eric-wieser/2.12-robot/software/Kinect/colour_125cm.jpg

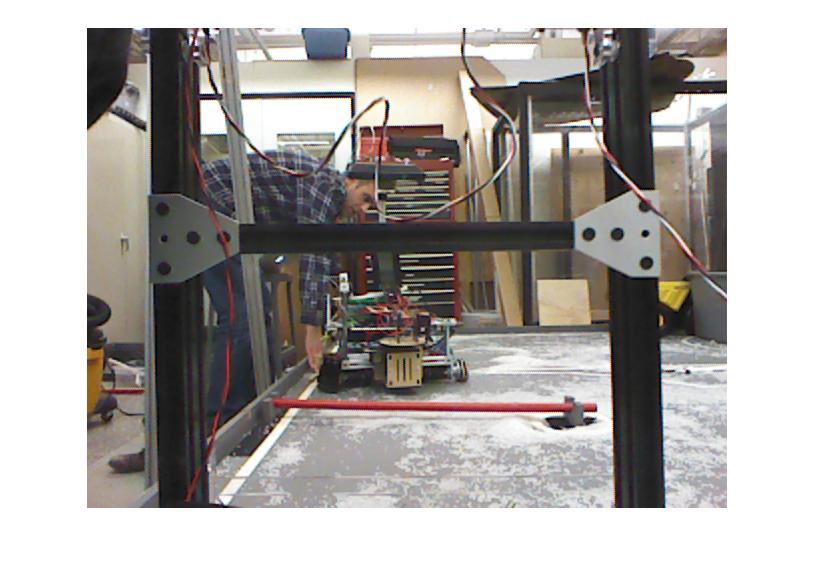
software/Kinect/colour_125cm.jpg
