eric-wieser/2.12-robot/README.md

2.12 CAD files for MECEM
========================
