eric-wieser/2.12-robot/software/README.md

Top level classes:

* Navigator
* Rail
* Arm
* ArenaPlotter

Note that due to problems with matlabs garbage collector, you pretty much have to restart matlab if the arduino connection goes to pieces
