eric-wieser/2.12-robot/software/embedded/README.md

You'll need a new version of the [motor driver library](https://github.com/eric-wieser/dual-mc33926-motor-shield) to run this code.

Most of the files here have been created by pulling apart the lab3 solution code.
