eric-wieser/2.12-robot/software/Arena.PNG

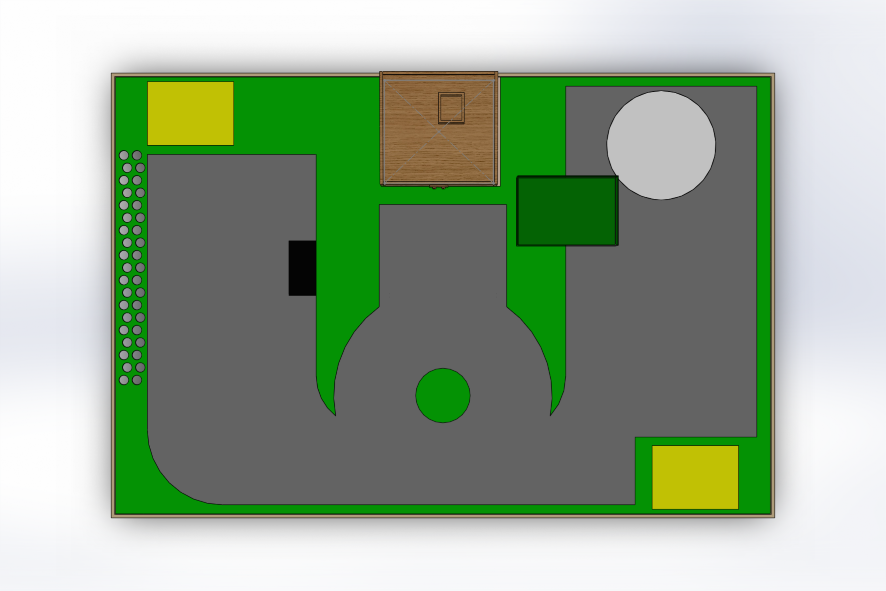
software/Arena.PNG
