eric-wieser/2.12-robot/software/Kinect/data.jpg

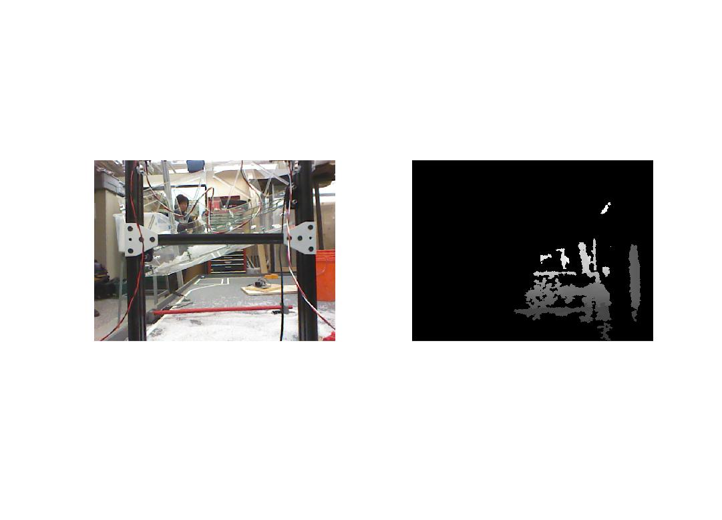
software/Kinect/data.jpg
