eric-wieser/2.12-robot/software/Kinect/depth_125cm.jpg

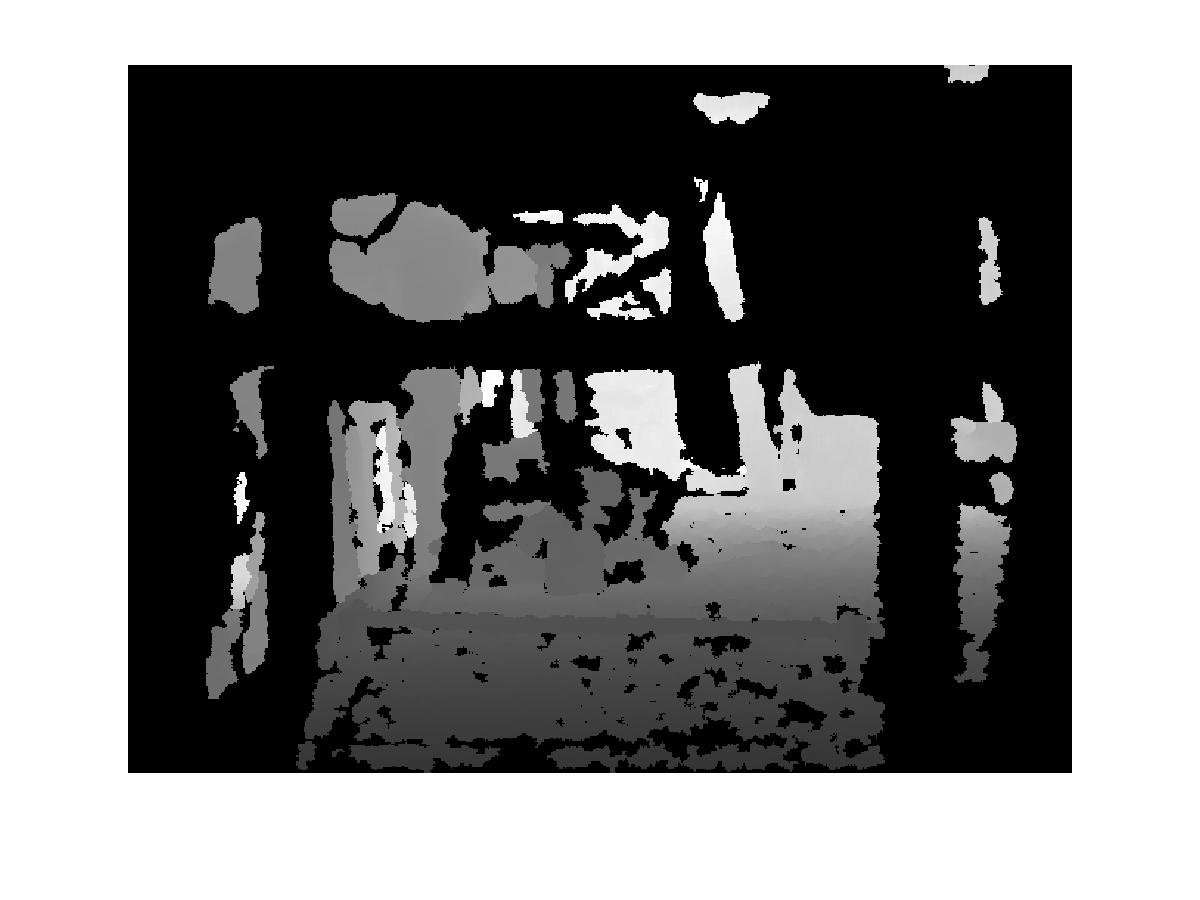
software/Kinect/depth_125cm.jpg
