eric-wieser/2.12-robot/hardware/Parts/Hand/Hand_new/Sheet4_scrapper.SLDASM

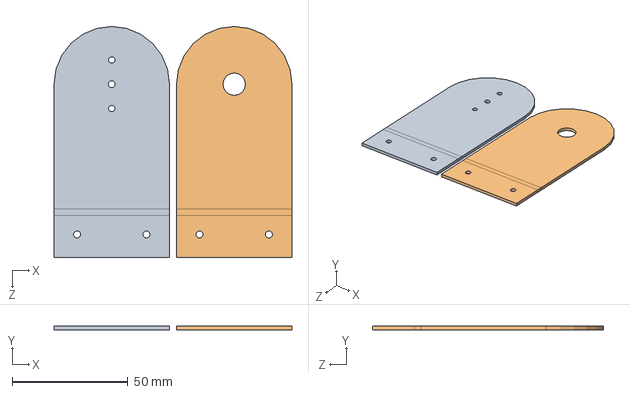
[picture p5: CAD file, 2015-12-03]
hardware/Parts/Hand/Hand_new/Sheet4_scrapper.SLDASM
103.0 x 1.59 x 100.0 mm
HandLink3_new
HandLink3_2_new
