eric-wieser/2.12-robot/hardware/Parts/Rail/Servo pulley with shaft.SLDASM

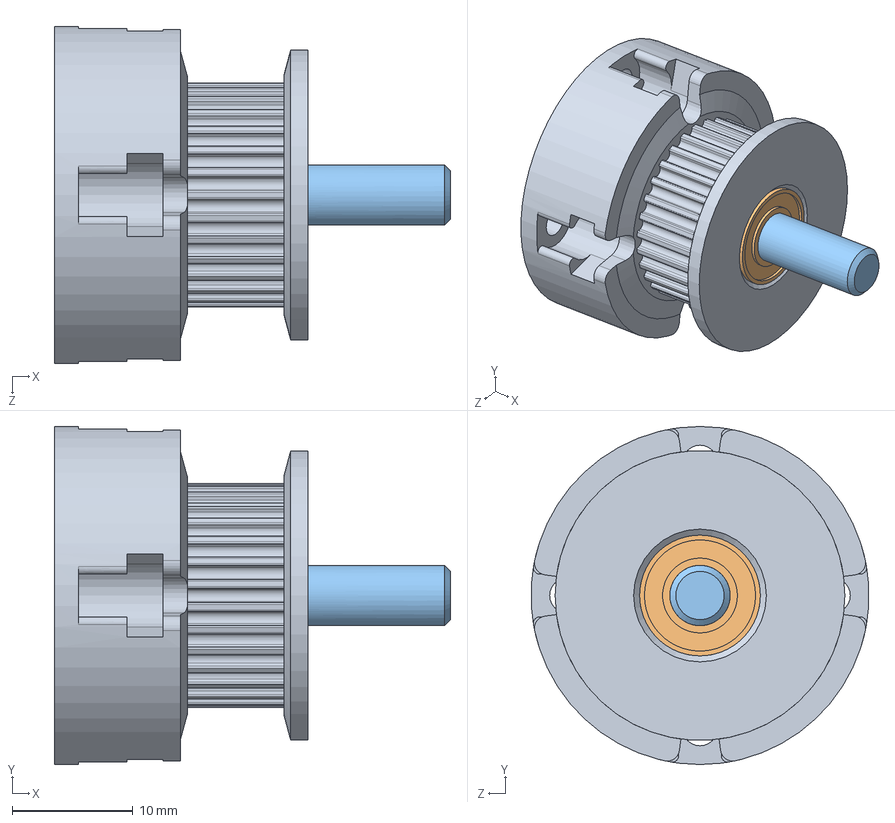
[picture p6: CAD file, 2015-12-03]
hardware/Parts/Rail/Servo pulley with shaft.SLDASM
32.8 x 28.0 x 27.9 mm
Servo Timing Pulley 30 Tooth
Ball Bearing 5 x 10 x 4.2 x 2
Low Profile Screw M5
