eric-wieser/2.12-robot/hardware/Parts/Sifter/Sifter.SLDASM

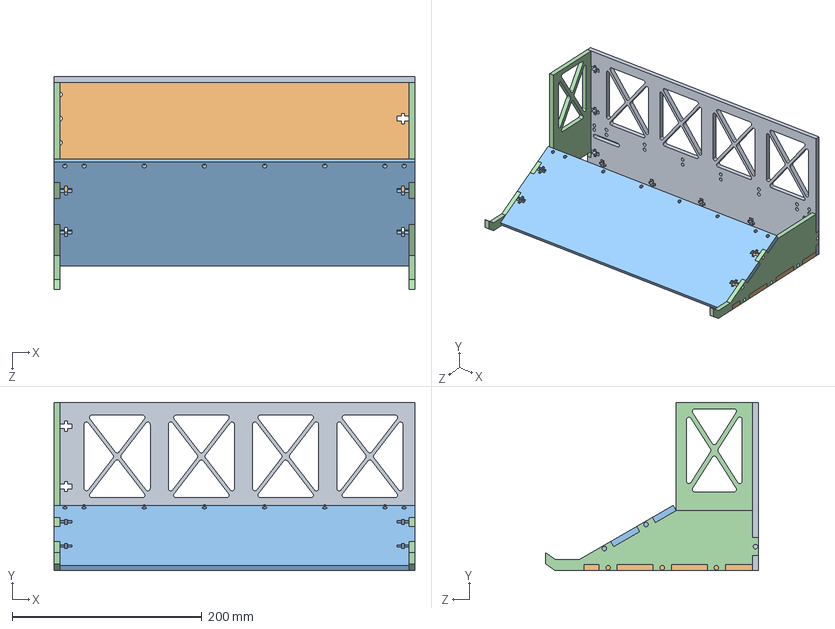
[picture p7: CAD file, 2015-12-01]
hardware/Parts/Sifter/Sifter.SLDASM
381.0 x 177.8 x 224.8 mm
Back_plate
Bottom_plate
front_plate
Bottom_side_panel x 2
