eric-wieser/2.12-robot/hardware/Top.SLDASM

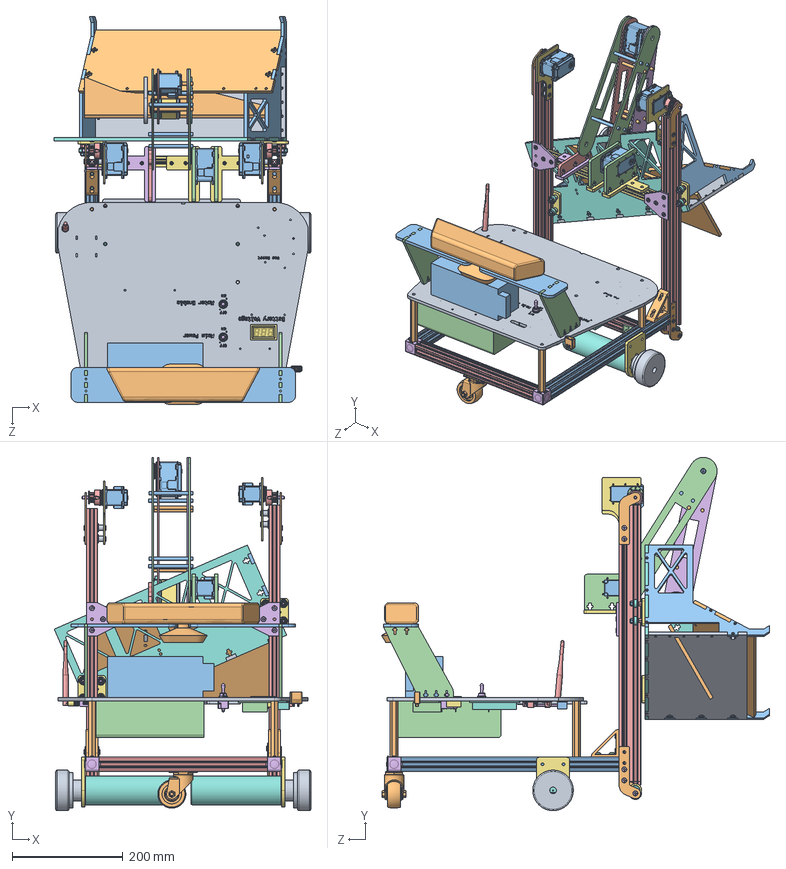
[picture p8: CAD file, 2015-12-03]
hardware/Top.SLDASM
463.9 x 639.1 x 701.7 mm
RobotTopPlatform_ZACK_EDIT
BaseStandoff x 4
EncoderBufferBoard
PC
wireless
usb
wireless2
zapt
Screen
Kinect_Sensor
Battery
DROK DCDC
Arduino UNO
Switch x 2
VDC1
ScreenBoard
ScreenHolder
xt90_male_asm
Kinect shelf plate
kinect shelf side panel x 2
8020_extrusion x 2
8020_corner x 2
motor mounting plate x 2
IG520053-SY3465 x 2
wheel_basic x 2
caster
47065T209bis x 2
47065T236 x 2
V-Slot 20x40x500 Linear Rail x 2
Double Tee Nut x 10
Mini V Wheel Plate x 2
Delrin Mini V Wheel x 8
Ball Bearing 5 x 10 x 4.2 x 20
Precision Shim 8 x 5 x 1 x 16
Nylon Insert Lock Nut M5 x 10
Aluminum Spacer 6mm x 4
Mini Eccentric Spacer 6mm x 4
Low Profile Screw M5 x 38
Smooth Idler Pulley Wheel x 2
Ball Bearing 5 x 16 x 5 x 4
Nylon Spacer 0.125in x 2
IdlerPlate x 6
MX-106T x 4
HN05-N102 x 4
Servo Timing Pulley 30 Tooth x 2
Aluminum Spacer 3mm x 4
Motor Mount x 2
Slot Washer 15 x 5 x 2 x 4
Aluminum Spacer 9mm x 4
Triangle_Bracket x 2
47065T147 End feed fastener without screws
47065T147 End feed fastener screws x 2
Tee Nut x 6
Joining Plate T x 2
Link
Back_plate
Bottom_plate
front_plate
Bottom_side_panel x 2
HandLink1_new x 2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
