eric-wieser/2.12-robot/Top.SLDASM

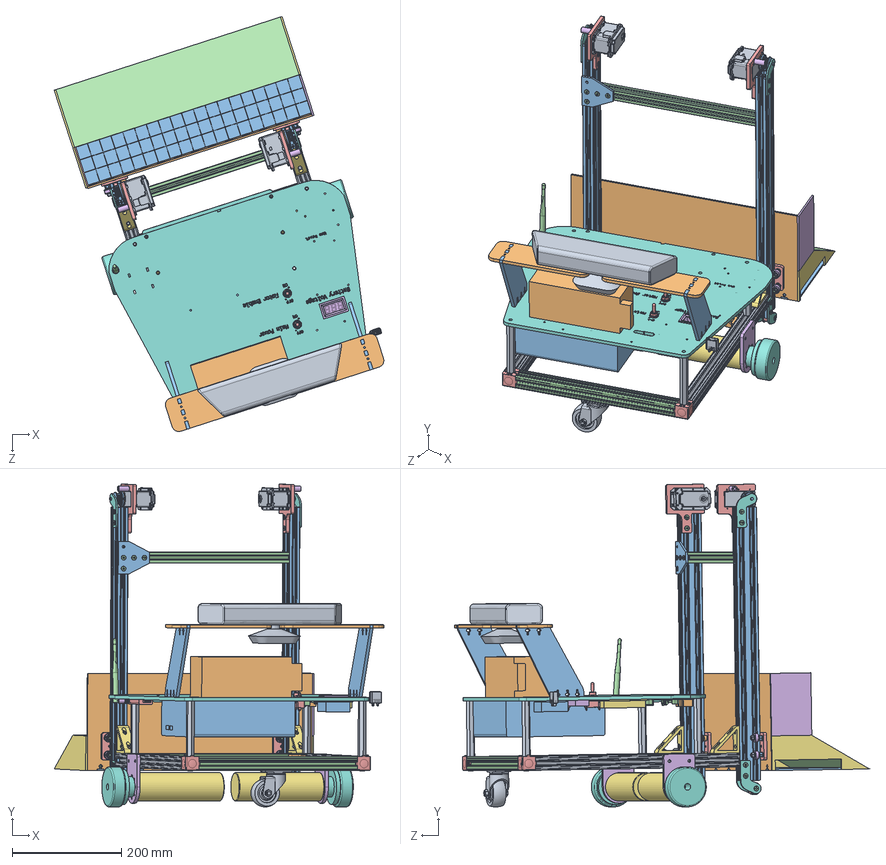
[picture p9: CAD file, 2015-11-05]
Top.SLDASM
603.1 x 590.5 x 759.1 mm
47065T209bis x 2
47065T236 x 2
V-Slot 20x40x500 Linear Rail x 2
Double Tee Nut x 10
Mini V Wheel Plate x 2
Delrin Mini V Wheel x 8
Ball Bearing 5 x 10 x 4.2 x 16
Precision Shim 8 x 5 x 1 x 16
Nylon Insert Lock Nut M5 x 10
Aluminum Spacer 6mm x 4
Mini Eccentric Spacer 6mm x 4
Low Profile Screw M5 x 32
Smooth Idler Pulley Wheel x 2
Ball Bearing 5 x 16 x 5 x 4
Nylon Spacer 0.125in x 2
IdlerPlate x 6
MX-106T x 2
HN05-N102 x 2
Servo Timing Pulley 30 Tooth x 2
Aluminum Spacer 3mm x 4
Motor Mount x 2
Aluminum Spacer 20mm x 2
Triangle_Bracket x 2
RobotTopPlatform_ZACK_EDIT
BaseStandoff x 4
EncoderBufferBoard
PC
wireless
usb
wireless2
zapt
Screen
Kinect_Sensor
Battery
DROK DCDC
Arduino UNO
Switch x 2
VDC1
ScreenBoard
ScreenHolder
xt90_male_asm
Kinect shelf plate
kinect shelf side panel x 2
8020_extrusion x 2
8020_corner x 2
motor mounting plate x 2
IG520053-SY3465 x 2
wheel_basic x 2
caster
Back_plate
Bottom_plate
front_plate
Chicken_wire
Top_side_panel
Bottom_side_panel x 2
47065T147 End feed fastener without screws
47065T147 End feed fastener screws x 2
Tee Nut x 2
Joining Plate T
V-Slot 20x20x500 Linear Rail - Link
