eric-wieser/2.12-robot/hardware/BaseRobot/TopAssembly.SLDASM

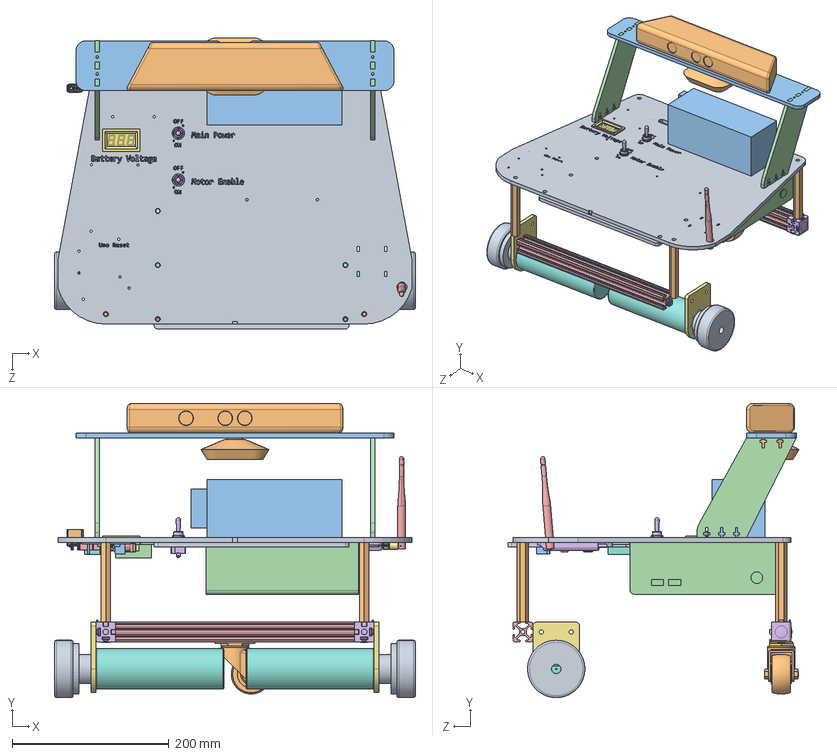
[picture p10: CAD file, 2015-12-03]
hardware/BaseRobot/TopAssembly.SLDASM
461.2 x 376.0 x 372.0 mm
RobotTopPlatform_ZACK_EDIT
BaseStandoff x 4
EncoderBufferBoard
PC
wireless
usb
wireless2
zapt
Screen
Kinect_Sensor
Battery
DROK DCDC
Arduino UNO
Switch x 2
VDC1
ScreenBoard
ScreenHolder
xt90_male_asm
Kinect shelf plate
kinect shelf side panel x 2
8020_extrusion x 2
8020_corner x 2
motor mounting plate x 2
IG520053-SY3465 x 2
wheel_basic x 2
caster
