eric-wieser/2.12-robot/hardware/Sheet2.SLDASM

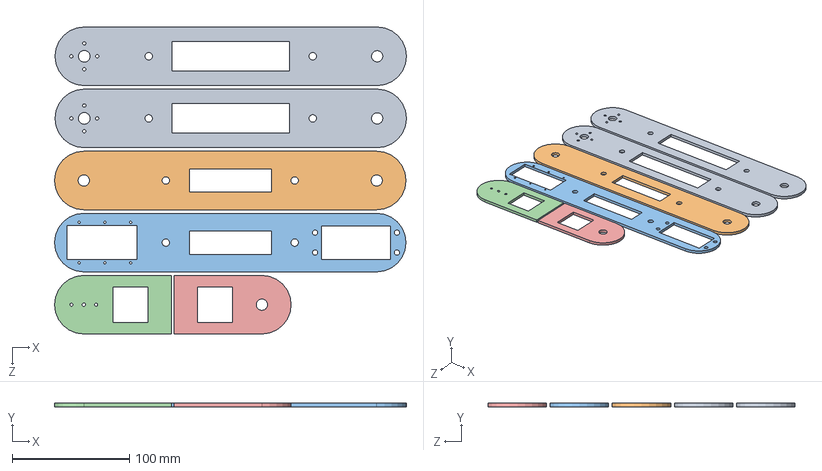
[picture p11: CAD file, 2015-12-01]
hardware/Sheet2.SLDASM
300.4 x 3.17 x 262.0 mm
HandLink1_new x 2
HandLink2_2_new
HandLink2_new_vs_11
HandLink3_new
HandLink3_2_new
