eric-wieser/2.12-robot/hardware/BaseRobot/TPLink.SLDASM

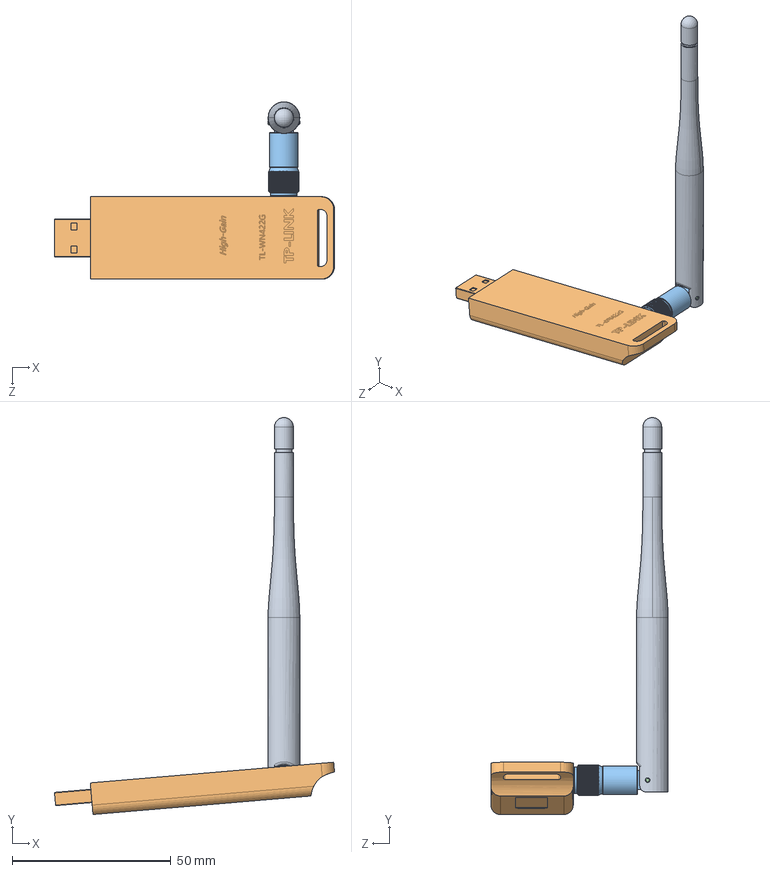
[picture p12: CAD file, 2015-12-01]
hardware/BaseRobot/TPLink.SLDASM
88.3 x 125.1 x 55.9 mm
wireless
usb
wireless2
zapt
