eric-wieser/2.12-robot/hardware/Parts/Hand/Hand_assembly.SLDASM

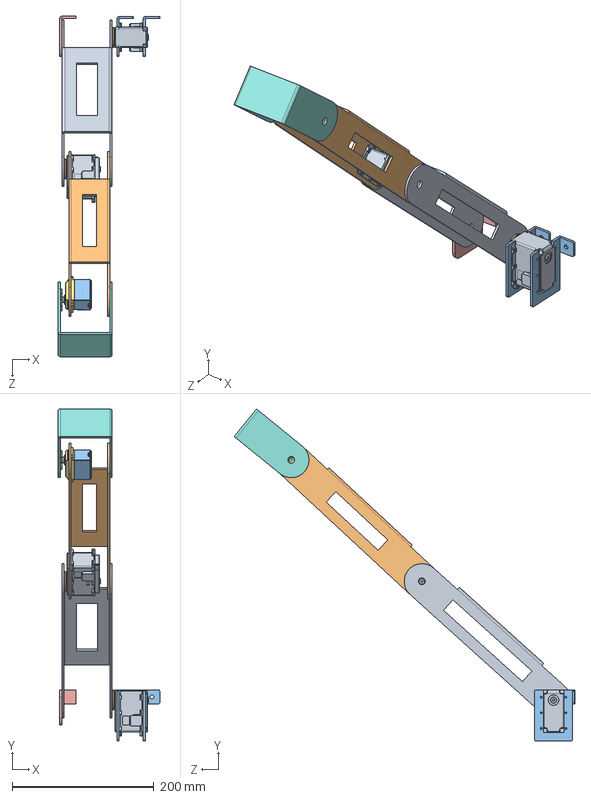
[picture p13: CAD file, 2015-11-13]
hardware/Parts/Hand/Hand_assembly.SLDASM
143.3 x 468.2 x 480.3 mm
HandLink1
HandLink2
MID_PLANT
chassis lower(None)
Output gear(M0.4x42T_FT)
SCREW M2.0XL28(None) x 4
chassis upper(None)
HandLink3
MX-106T x 2
HN05-N102 x 2
ServoMountArm x 2
ServoHornLink2
HandLink1Mount
