eric-wieser/2.12-robot/hardware/Parts/Hand/Hand_new/Hand_assembly_new.SLDASM

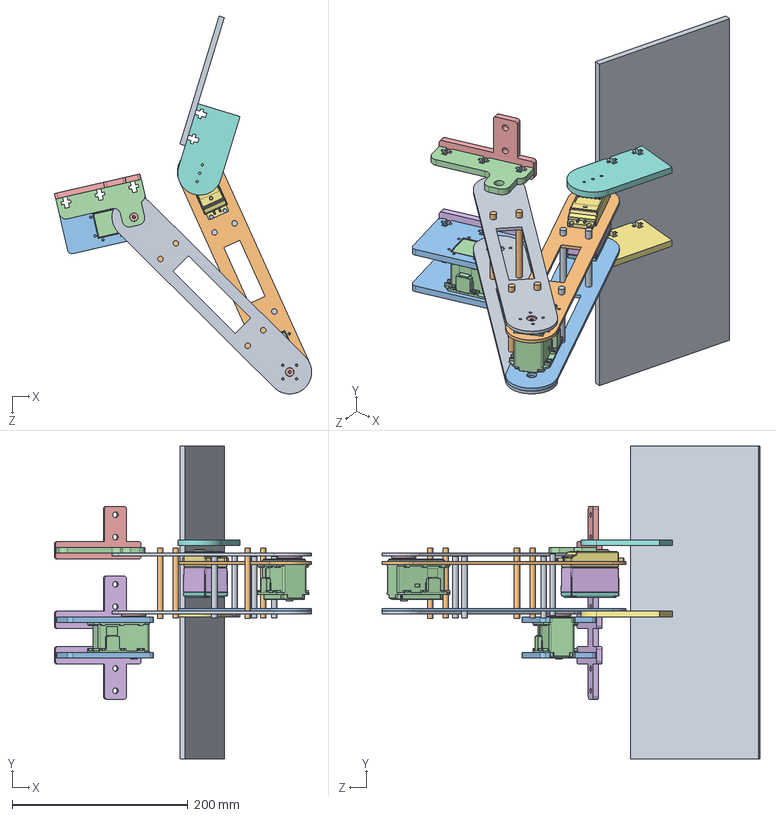
[picture p14: CAD file, 2015-12-03]
hardware/Parts/Hand/Hand_new/Hand_assembly_new.SLDASM
292.8 x 355.6 x 430.0 mm
HandLink1_new x 2
HandLink2_new_vs_11
HandLink2_2_new
MX-106T x 2
HN05-N102 x 2
MID-PLANT
CHASSIS-UPPER
CHASSIS-LOWER
LinkingBar x 4
LinkingBar2 x 4
Motor_mount_angled x 2
arm_mount
mounting_plate
motor_mount_large
Servo-arm-link
Servo-Scraper_link
Scraper_acrylic
