eric-wieser/2.12-robot/hardware/Parts/Rail/Rail.SLDASM

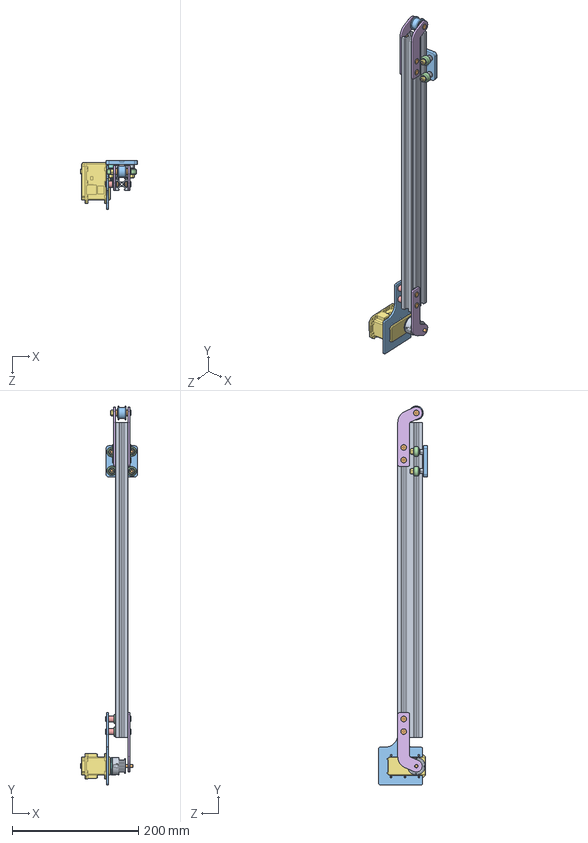
[picture p15: CAD file, 2015-12-03]
hardware/Parts/Rail/Rail.SLDASM
90.5 x 601.4 x 77.7 mm
V-Slot 20x40x500 Linear Rail
Double Tee Nut x 4
Mini V Wheel Plate
Delrin Mini V Wheel x 4
Ball Bearing 5 x 10 x 4.2 x 10
Precision Shim 8 x 5 x 1 x 8
Nylon Insert Lock Nut M5 x 5
Aluminum Spacer 6mm x 2
Mini Eccentric Spacer 6mm x 2
Low Profile Screw M5 x 14
Smooth Idler Pulley Wheel
Ball Bearing 5 x 16 x 5 x 2
Nylon Spacer 0.125in
IdlerPlate x 3
MX-106T
HN05-N102
Servo Timing Pulley 30 Tooth
Aluminum Spacer 3mm x 2
Motor Mount
Slot Washer 15 x 5 x 2 x 2
Aluminum Spacer 9mm x 2
