eric-wieser/2.12-robot/hardware/Sheet1.SLDASM

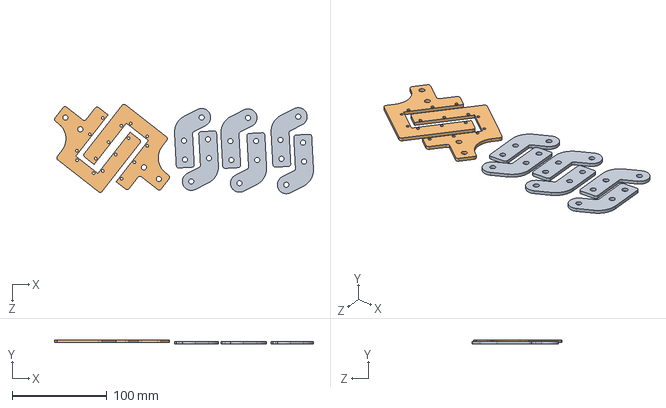
[picture p16: CAD file, 2015-11-13]
hardware/Sheet1.SLDASM
273.0 x 4.50 x 94.4 mm
IdlerPlate x 6
Motor Mount x 2
