eric-wieser/2.12-robot/hardware/Arena/Board Assembly.SLDASM

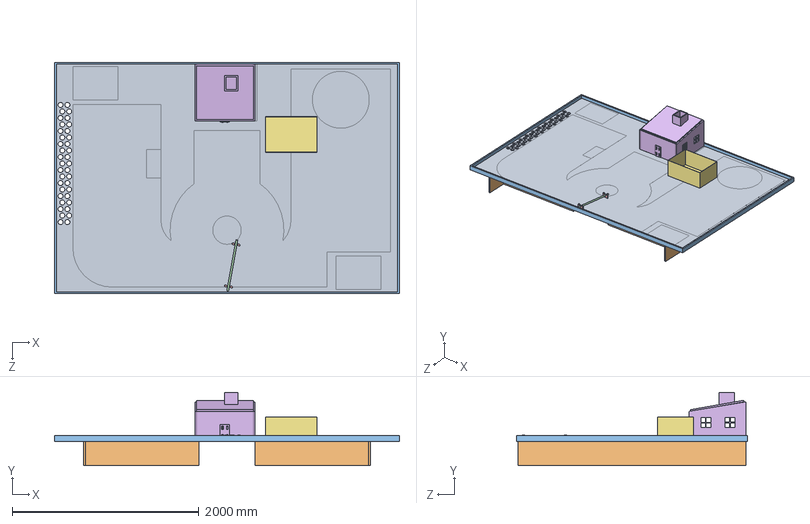
[picture p17: CAD file, 2015-10-30]
hardware/Arena/Board Assembly.SLDASM
3695.7 x 784.5 x 2476.5 mm
Board
Base
Wall
Tree
Tree Support
house
dumpster
