eric-wieser/2.12-robot/hardware/Arena/Tree Assembly.SLDASM

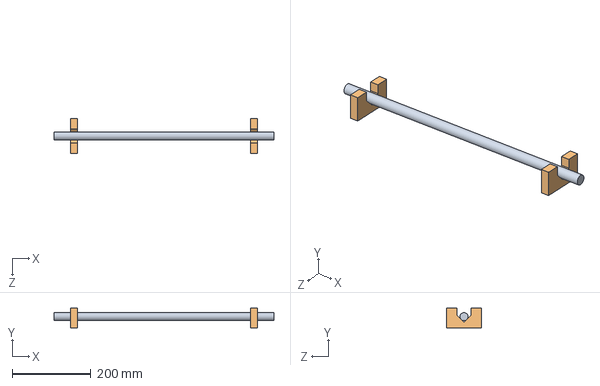
[picture p18: CAD file, 2015-10-30]
hardware/Arena/Tree Assembly.SLDASM
558.8 x 50.8 x 88.9 mm
Tree
Tree Support
