eric-wieser/2.12-robot/hardware/BaseRobot/Switch/S1A.SLDASM

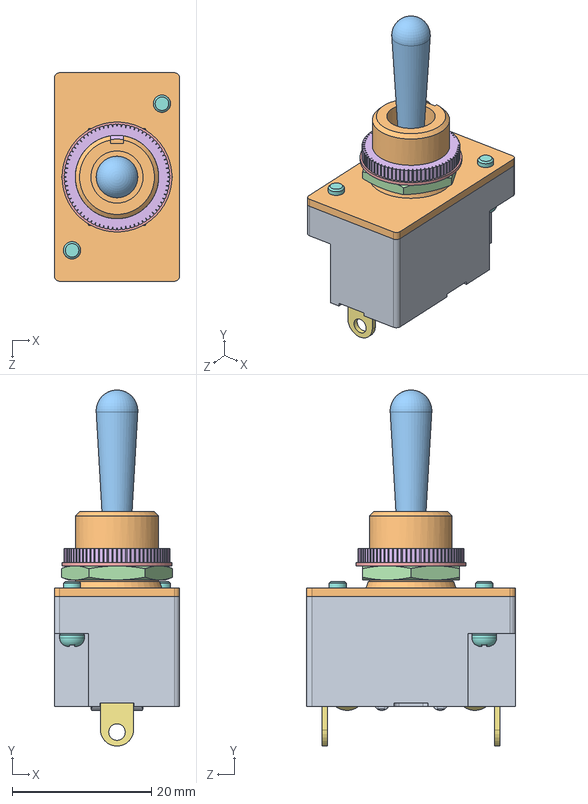
[picture p19: CAD file, 2015-11-02]
hardware/BaseRobot/Switch/S1A.SLDASM
18.0 x 51.2 x 30.0 mm
