eric-wieser/2.12-robot/hardware/BaseRobot/xt90_male_asm.SLDPRT

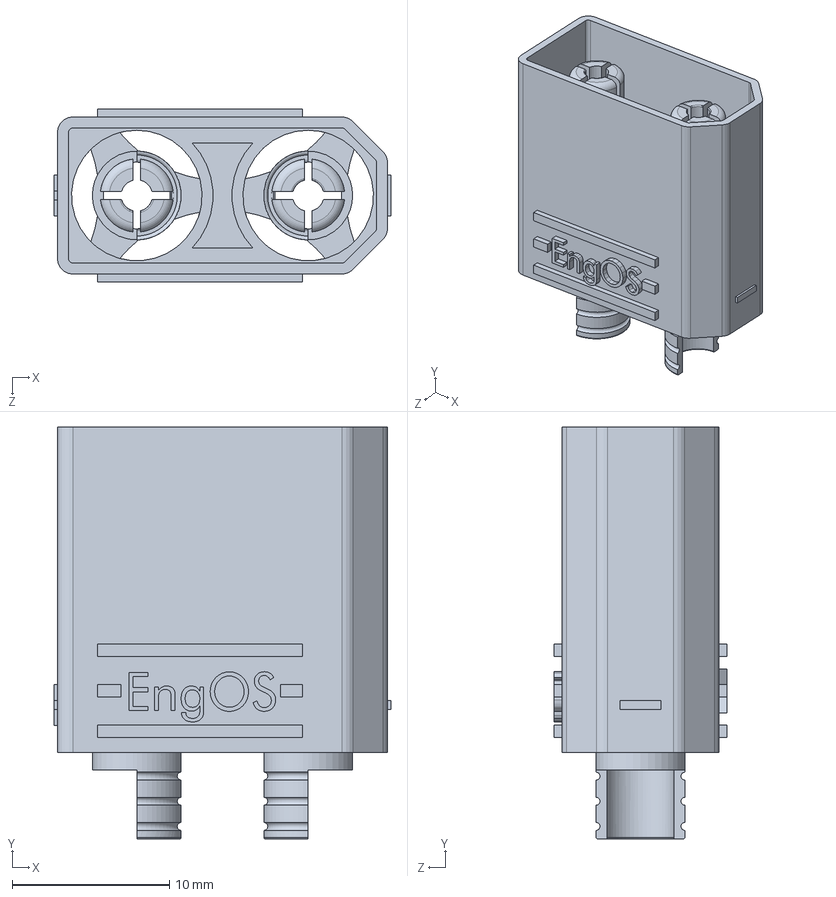
[picture p20: CAD file, 2015-11-02]
hardware/BaseRobot/xt90_male_asm.SLDPRT
21.4 x 26.2 x 11.0 mm
