eric-wieser/2.12-robot/hardware/Parts/Hand/Hand_new/Sheet3_mounts.SLDASM

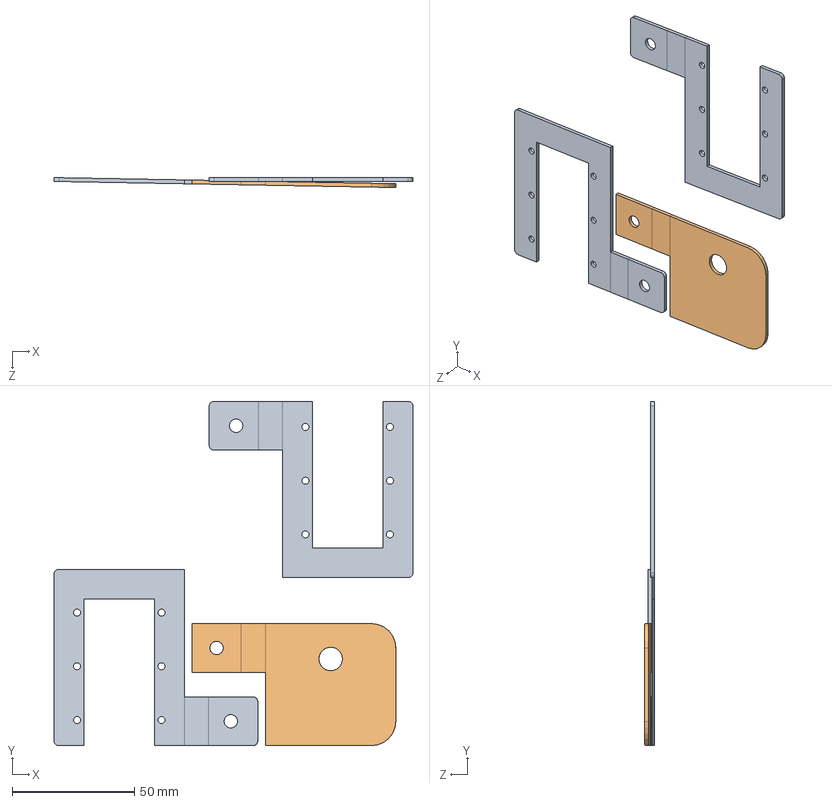
[picture p21: CAD file, 2015-12-02]
hardware/Parts/Hand/Hand_new/Sheet3_mounts.SLDASM
147.0 x 141.0 x 4.15 mm
ServoMountArm x 2
HandLink1Mount
