eric-wieser/2.12-robot/hardware/Parts/Hand/Hand_new/Sheet2.SLDASM

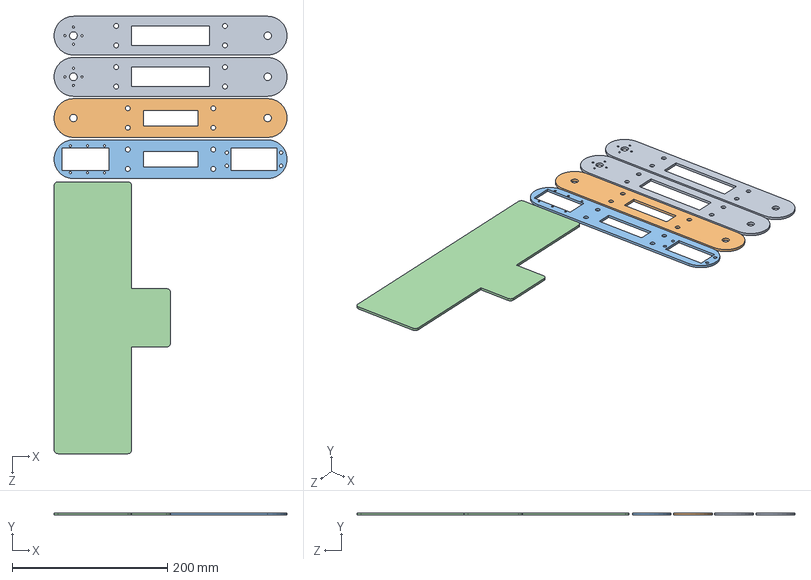
[picture p22: CAD file, 2015-12-01]
hardware/Parts/Hand/Hand_new/Sheet2.SLDASM
299.8 x 3.17 x 563.0 mm
HandLink1_new x 2
HandLink2_2_new
HandLink2_new_vs_11
Scrapper
