eric-wieser/2.12-robot/hardware/Arena/dumpster.SLDPRT

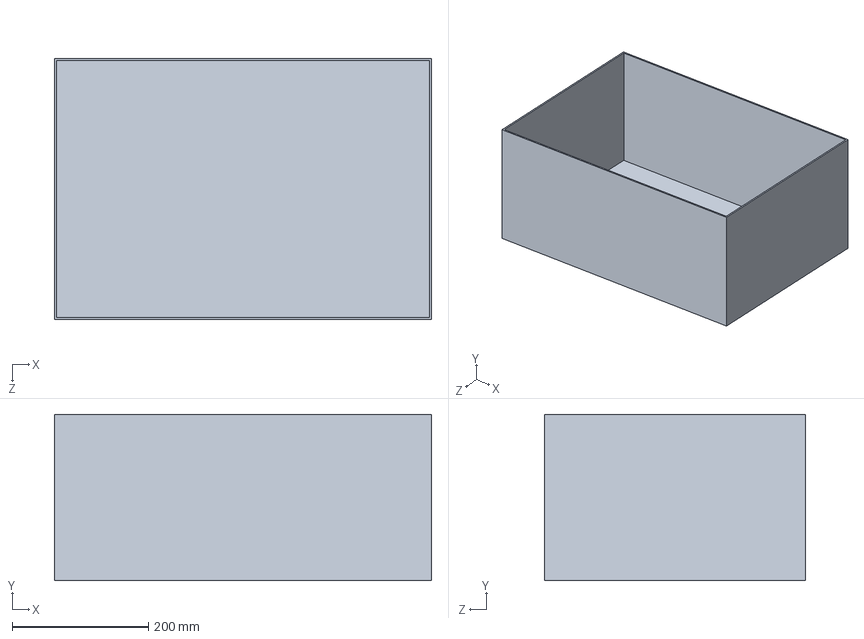
[picture p23: CAD file, 2015-10-30]
hardware/Arena/dumpster.SLDPRT
553.7 x 243.8 x 383.5 mm
