eric-wieser/2.12-robot/hardware/BaseRobot/kinect shelf side panel.SLDPRT

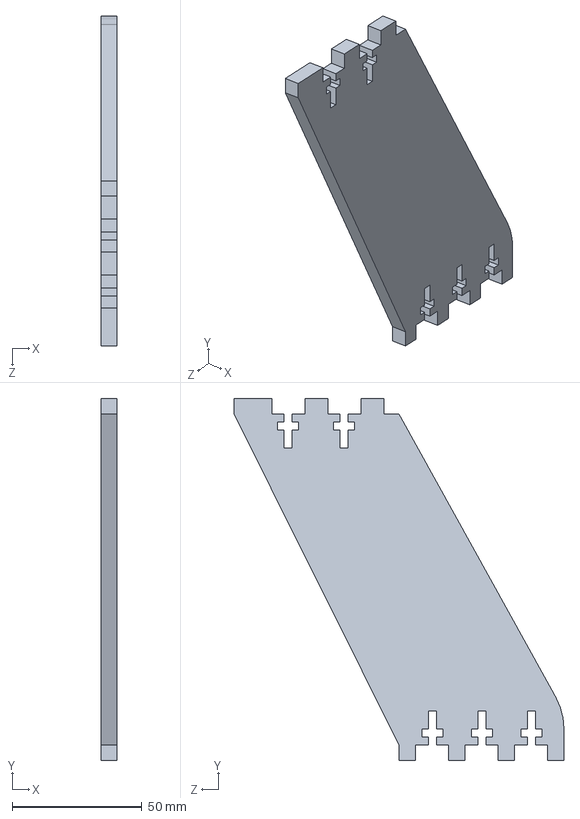
[picture p24: CAD file, 2015-12-03]
hardware/BaseRobot/kinect shelf side panel.SLDPRT
6.00 x 139.4 x 127.0 mm
