eric-wieser/2.12-robot/hardware/BaseRobot/TPLink/usb.sldprt

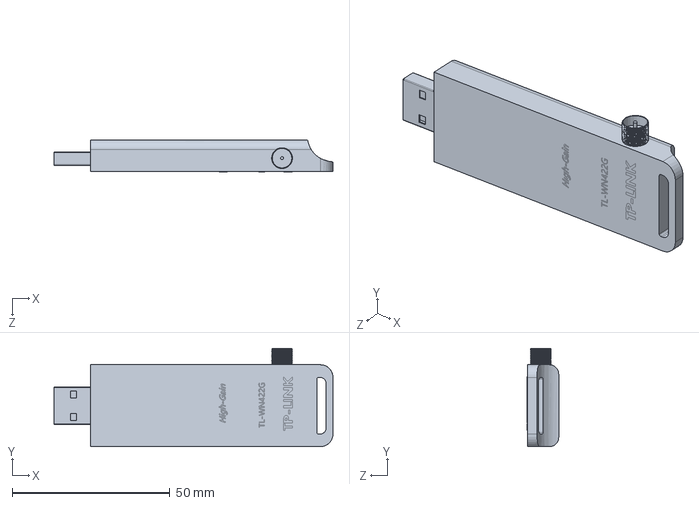
[picture p25: CAD file, 2015-11-02]
hardware/BaseRobot/TPLink/usb.sldprt
88.5 x 31.2 x 10.0 mm
