eric-wieser/2.12-robot/hardware/Parts/Hand/HandLink3.SLDPRT

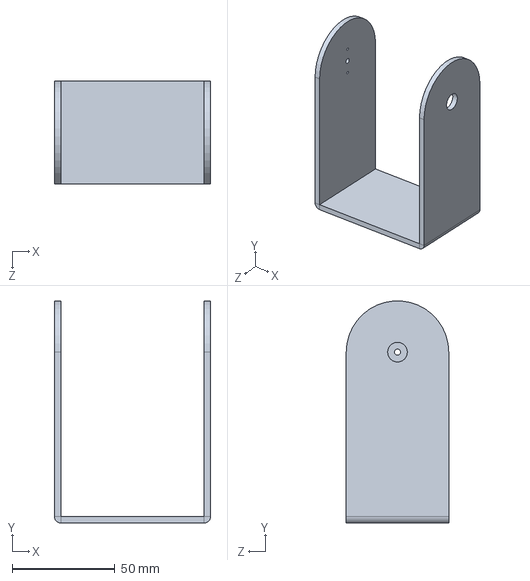
[picture p26: CAD file, 2015-12-01]
hardware/Parts/Hand/HandLink3.SLDPRT
76.2 x 108.2 x 50.0 mm
