eric-wieser/2.12-robot/hardware/Parts/Link.SLDPRT

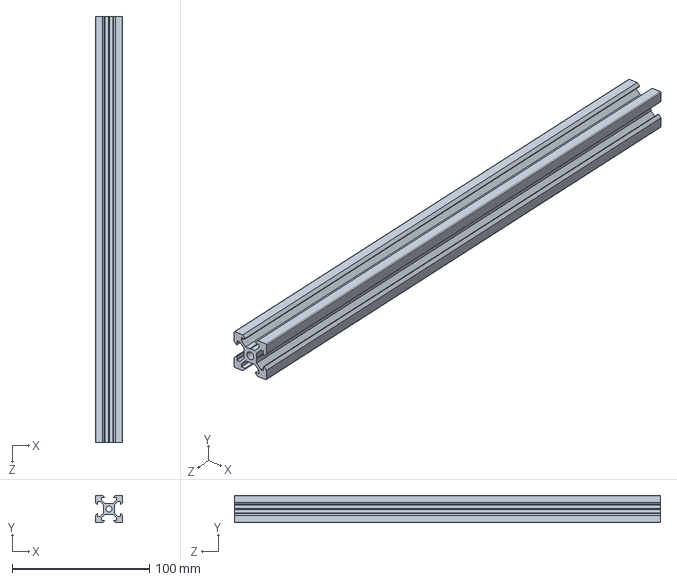
[picture p27: CAD file, 2015-12-03]
hardware/Parts/Link.SLDPRT
20.0 x 20.0 x 310.2 mm
