eric-wieser/2.12-robot/hardware/Arena/Tree.SLDPRT

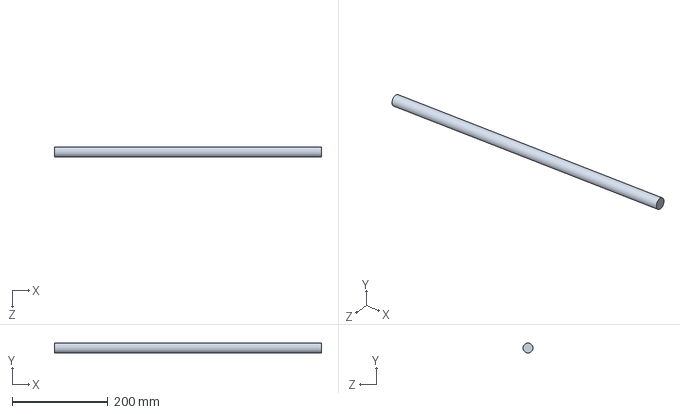
[picture p29: CAD file, 2015-10-30]
hardware/Arena/Tree.SLDPRT
558.8 x 20.6 x 20.6 mm
