eric-wieser/2.12-robot/hardware/Parts/Hand/Hand_new/Scraper_acrylic.SLDPRT

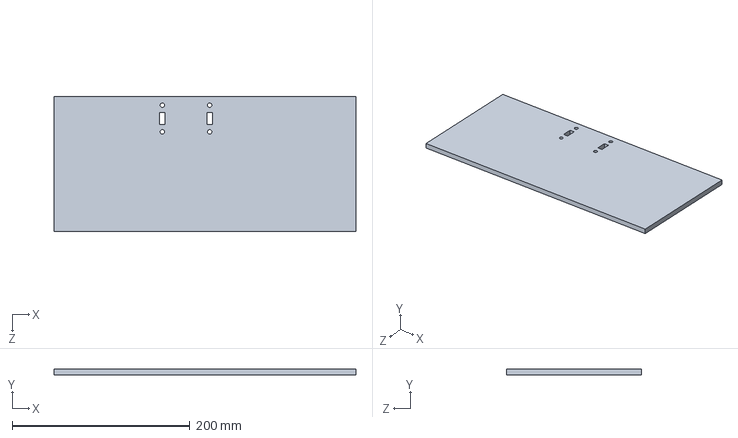
[picture p30: CAD file, 2015-12-03]
hardware/Parts/Hand/Hand_new/Scraper_acrylic.SLDPRT
340.0 x 6.35 x 152.4 mm
