eric-wieser/2.12-robot/hardware/Parts/Hand/HandLink1Mount.SLDPRT

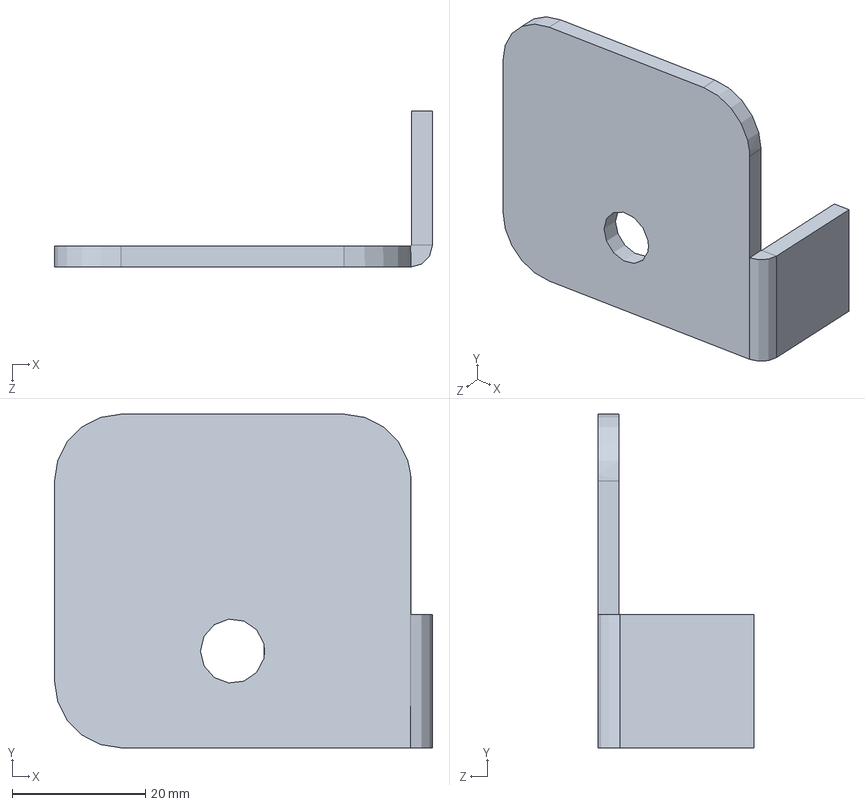
[picture p31: CAD file, 2015-11-22]
hardware/Parts/Hand/HandLink1Mount.SLDPRT
56.6 x 50.0 x 23.4 mm
