eric-wieser/2.12-robot/hardware/Parts/Motor Mount.SLDPRT

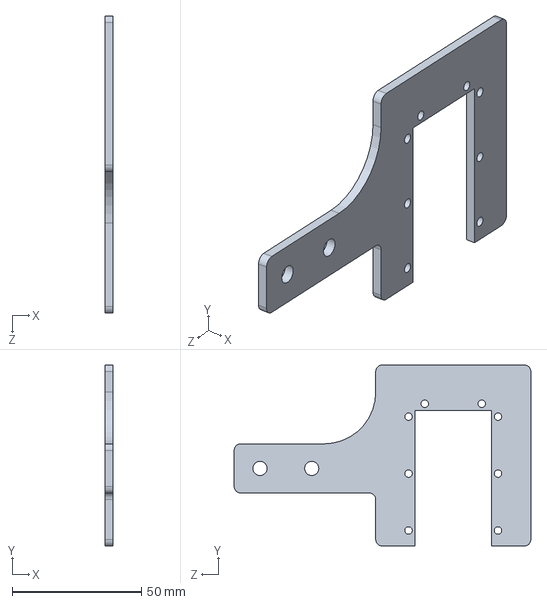
[picture p32: CAD file, 2015-12-03]
hardware/Parts/Motor Mount.SLDPRT
3.00 x 70.0 x 114.7 mm
