eric-wieser/2.12-robot/hardware/Parts/Rail/Servo Timing Pulley 30 Tooth.SLDPRT

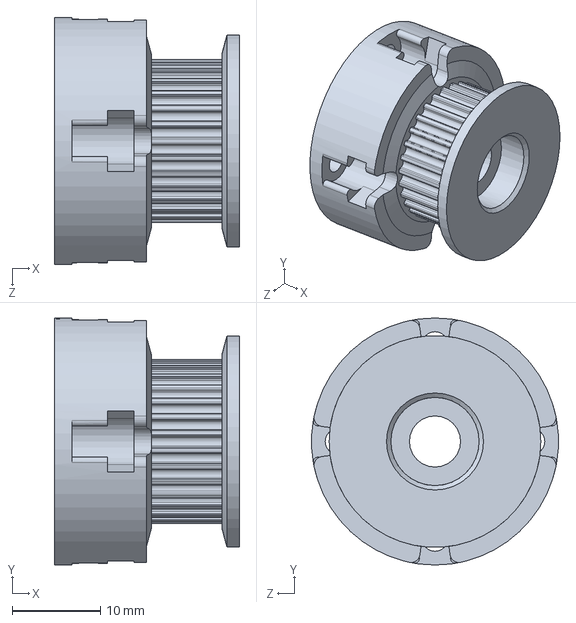
[picture p33: CAD file, 2015-12-03]
hardware/Parts/Rail/Servo Timing Pulley 30 Tooth.SLDPRT
21.0 x 28.0 x 27.9 mm
