eric-wieser/2.12-robot/hardware/Parts/Sifter/Bottom_plate.SLDPRT

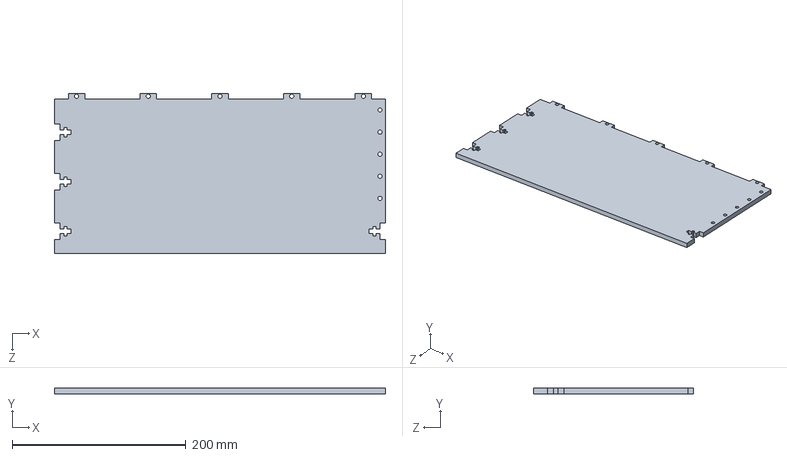
[picture p34: CAD file, 2015-12-01]
hardware/Parts/Sifter/Bottom_plate.SLDPRT
381.0 x 6.35 x 184.1 mm
