eric-wieser/2.12-robot/hardware/Arena/house.SLDPRT

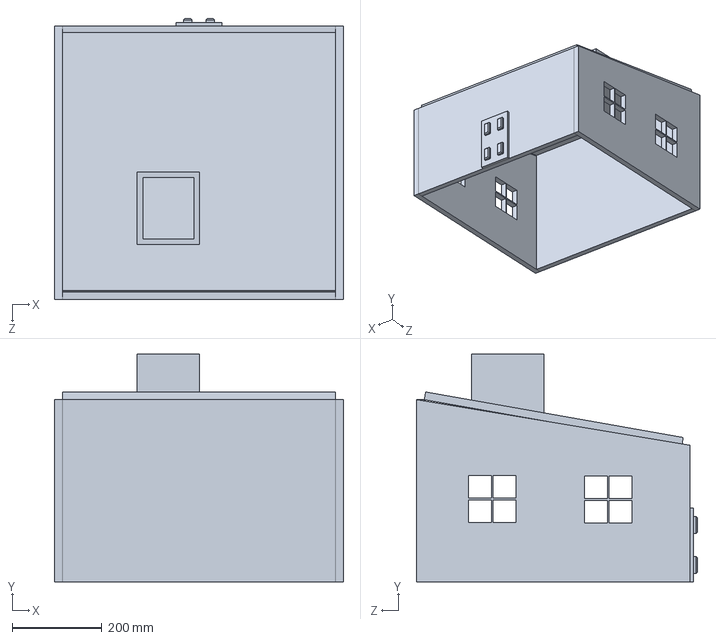
[picture p36: CAD file, 2015-10-30]
hardware/Arena/house.SLDPRT
644.5 x 508.0 x 627.1 mm
