eric-wieser/2.12-robot/hardware/Parts/Sifter/Back_plate.SLDPRT

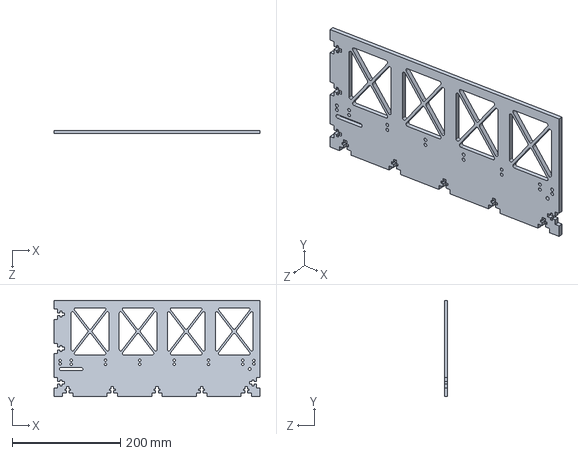
[picture p37: CAD file, 2015-11-20]
hardware/Parts/Sifter/Back_plate.SLDPRT
381.0 x 177.8 x 6.35 mm
