eric-wieser/2.12-robot/hardware/Arena/Base.SLDPRT

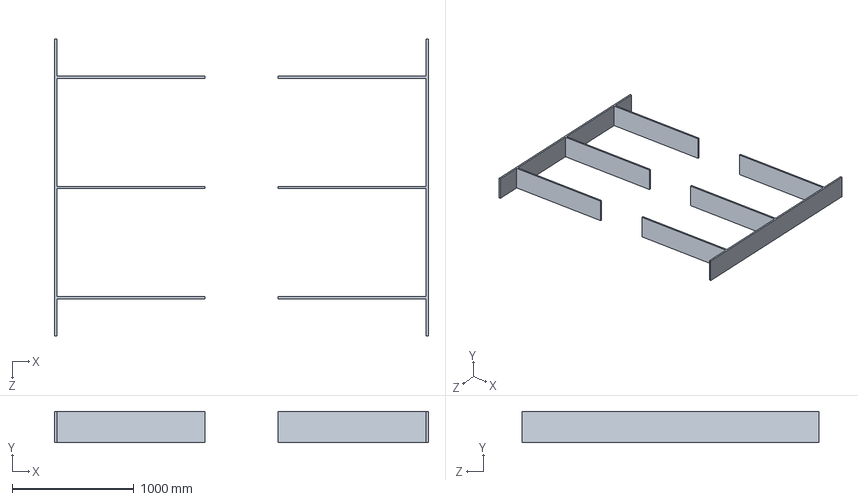
[picture p39: CAD file, 2015-10-30]
hardware/Arena/Base.SLDPRT
3073.4 x 257.2 x 2438.4 mm
