eric-wieser/2.12-robot/hardware/BaseRobot/RobotTopPlatform.SLDPRT

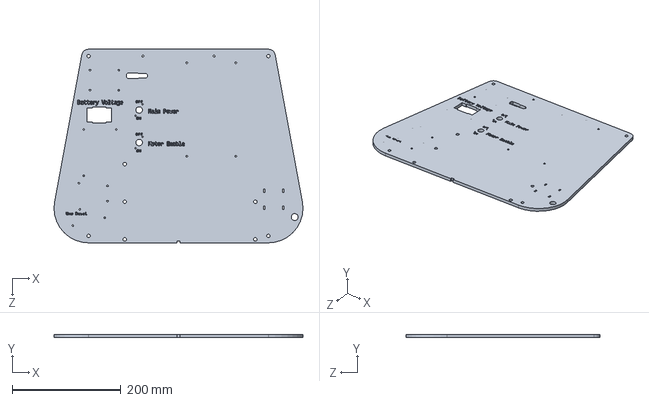
[picture p40: CAD file, 2015-11-02]
hardware/BaseRobot/RobotTopPlatform.SLDPRT
457.2 x 6.35 x 355.6 mm
