eric-wieser/2.12-robot/hardware/Parts/Hand/Hand_new/Servo-arm-link.SLDPRT

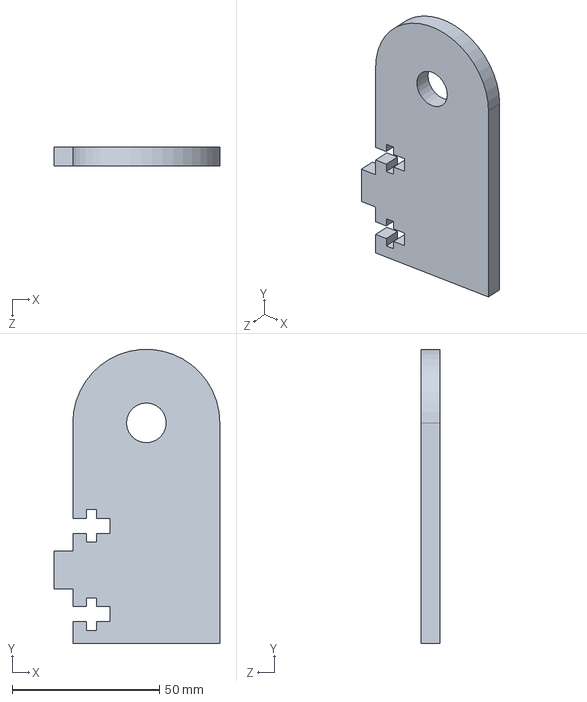
[picture p42: CAD file, 2015-12-03]
hardware/Parts/Hand/Hand_new/Servo-arm-link.SLDPRT
56.4 x 99.9 x 6.35 mm
