eric-wieser/2.12-robot/hardware/Parts/Hand/HandLink1.SLDPRT

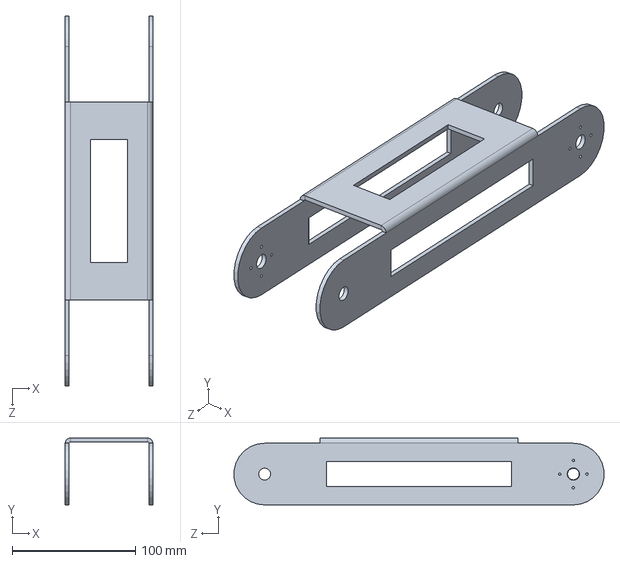
[picture p43: CAD file, 2015-11-13]
hardware/Parts/Hand/HandLink1.SLDPRT
71.0 x 54.2 x 299.6 mm
