eric-wieser/2.12-robot/hardware/Parts/Rail/Motor Mount.DXF

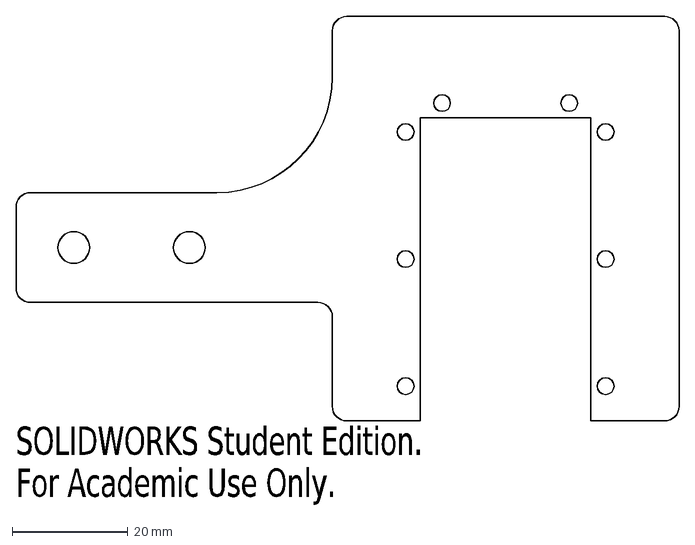
[picture p44: CAD file, 2015-12-03]
hardware/Parts/Rail/Motor Mount.DXF
SOLIDWORKS Student Edition.
For Academic Use Only.
