eric-wieser/2.12-robot/hardware/Parts/Sifter/CorelDrawDXF/front_plate_1.DXF

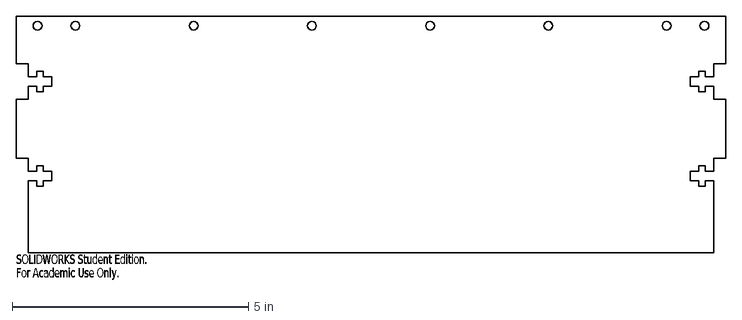
[picture p45: CAD file, 2015-12-01]
hardware/Parts/Sifter/CorelDrawDXF/front_plate_1.DXF
SOLIDWORKS Student Edition.
For Academic Use Only.
