eric-wieser/2.12-robot/hardware/Parts/Sifter/front_plate.SLDPRT

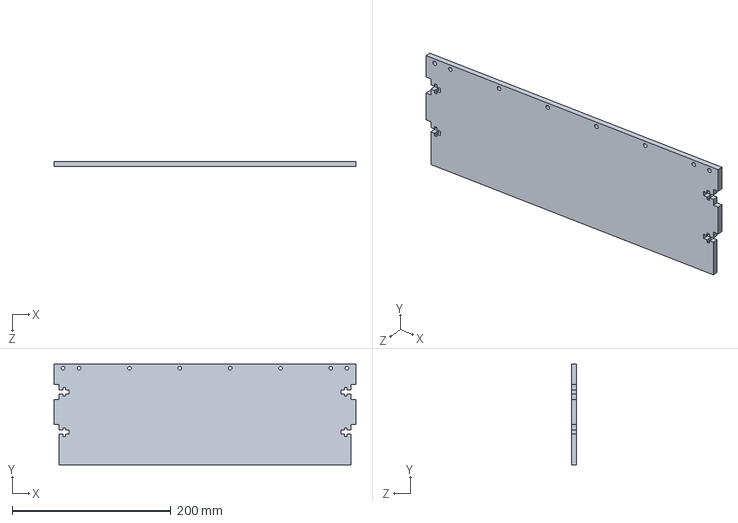
[picture p46: CAD file, 2015-11-20]
hardware/Parts/Sifter/front_plate.SLDPRT
381.0 x 127.0 x 6.35 mm
