eric-wieser/2.12-robot/hardware/Arena/Tree Support.SLDPRT

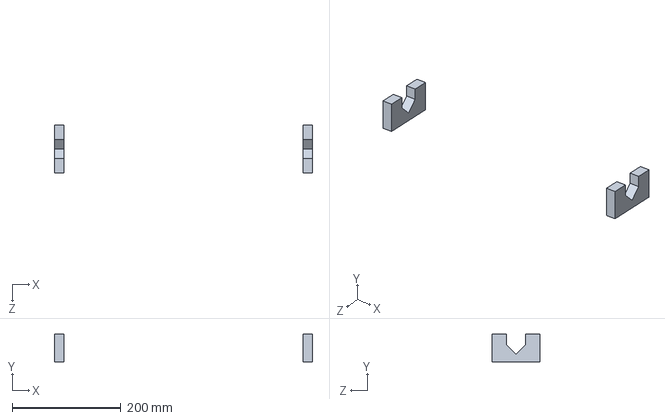
[picture p47: CAD file, 2015-10-30]
hardware/Arena/Tree Support.SLDPRT
474.7 x 50.8 x 88.9 mm
