eric-wieser/2.12-robot/hardware/BaseRobot/Battery.SLDPRT

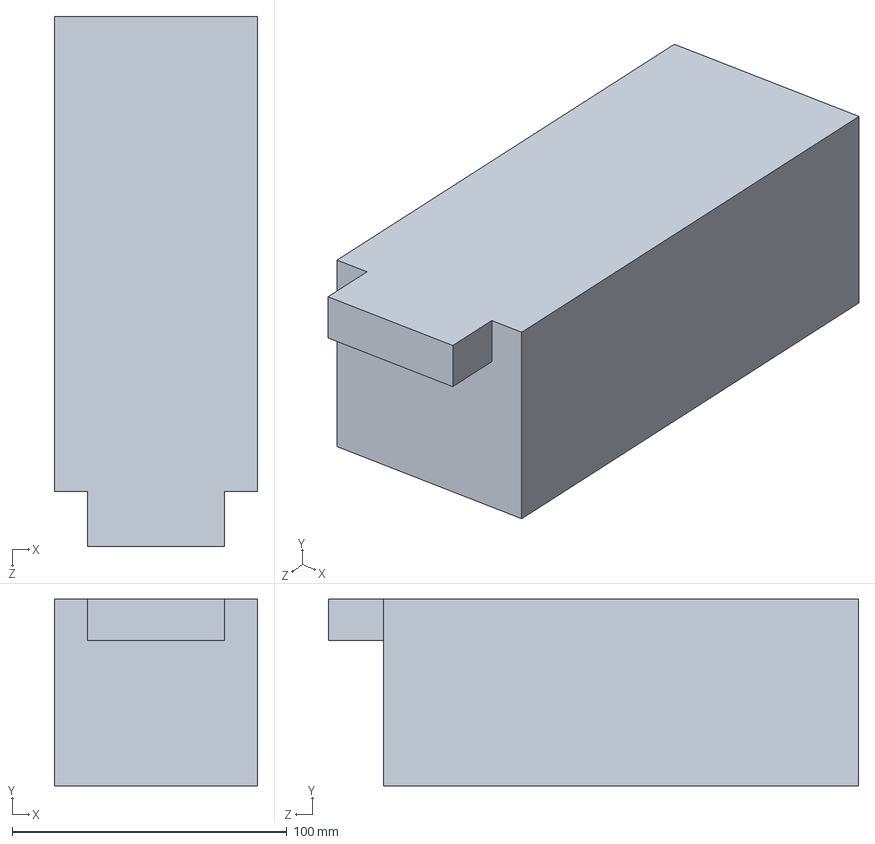
[picture p48: CAD file, 2015-11-02]
hardware/BaseRobot/Battery.SLDPRT
74.0 x 68.0 x 193.0 mm
