eric-wieser/2.12-robot/hardware/Parts/Hand/HandLink2.SLDPRT

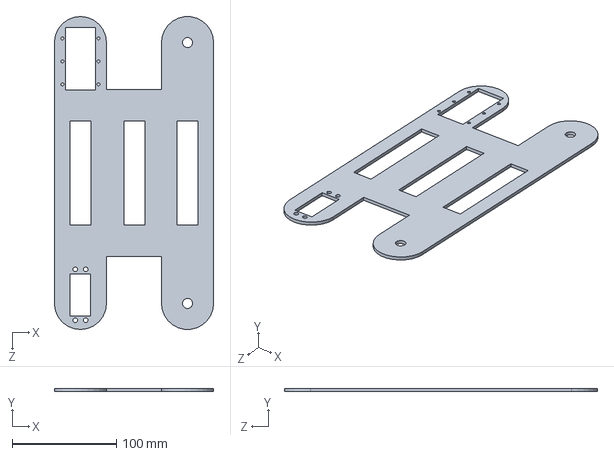
[picture p49: CAD file, 2015-11-13]
hardware/Parts/Hand/HandLink2.SLDPRT
152.6 x 3.17 x 300.0 mm
