eric-wieser/2.12-robot/hardware/Parts/Sifter/Bottom_side_panel.SLDPRT

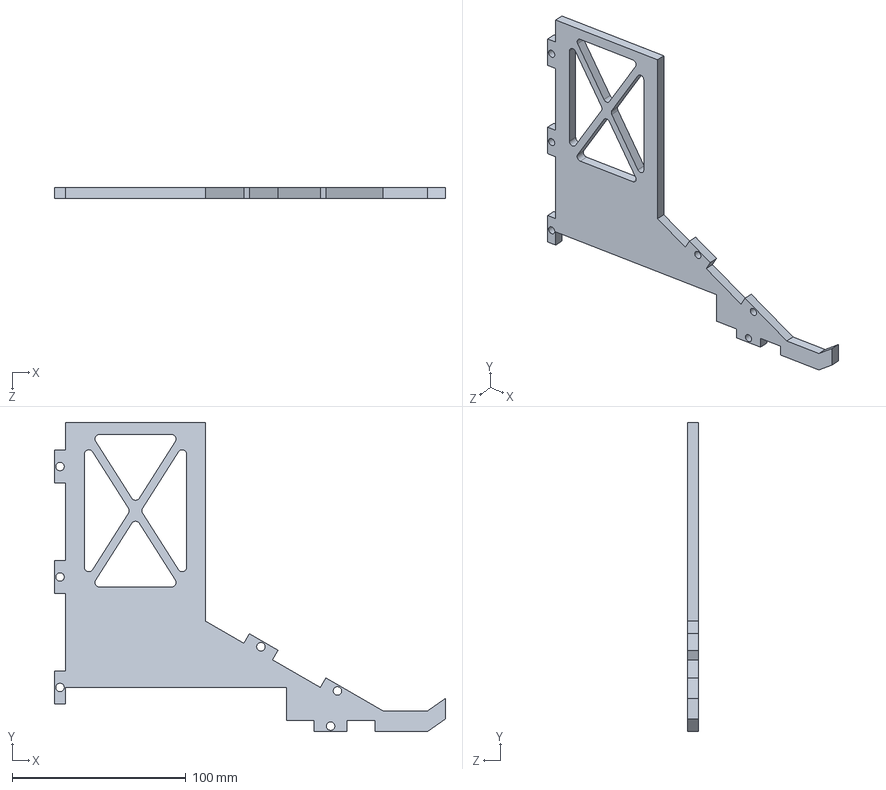
[picture p50: CAD file, 2015-11-20]
hardware/Parts/Sifter/Bottom_side_panel.SLDPRT
224.8 x 177.8 x 6.35 mm
