eric-wieser/2.12-robot/hardware/BaseRobot/caster.SLDPRT

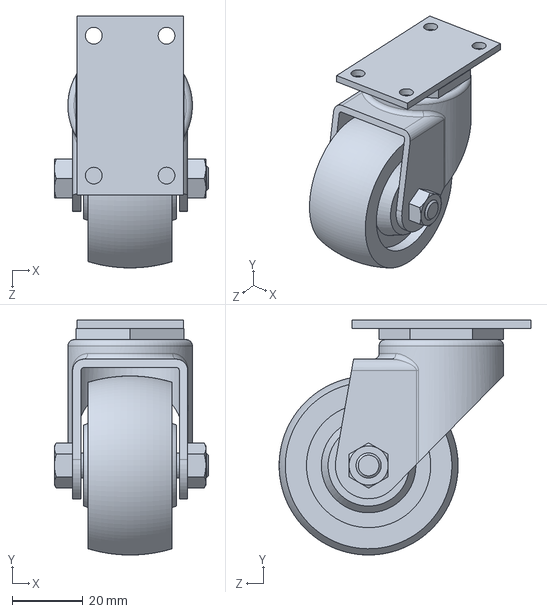
[picture p52: CAD file, 2015-11-02]
hardware/BaseRobot/caster.SLDPRT
43.7 x 66.7 x 71.4 mm
