eric-wieser/2.12-robot/hardware/Parts/Hand/Hand_new/motor_mount_large.SLDPRT

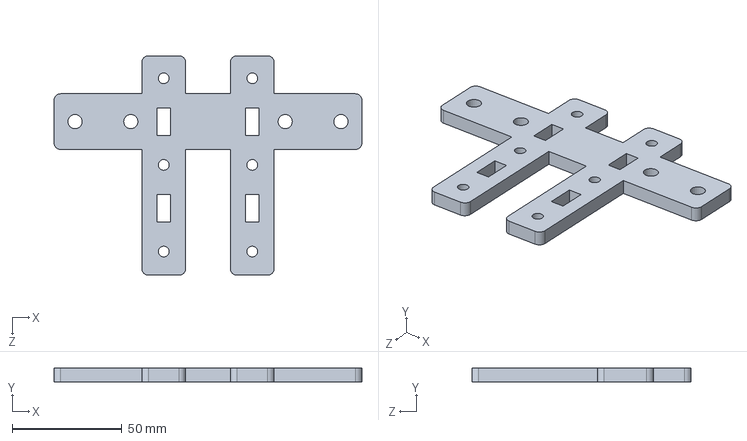
[picture p53: CAD file, 2015-12-03]
hardware/Parts/Hand/Hand_new/motor_mount_large.SLDPRT
140.3 x 6.35 x 100.0 mm
