eric-wieser/2.12-robot/hardware/Parts/Hand/ServoMountArm.SLDPRT

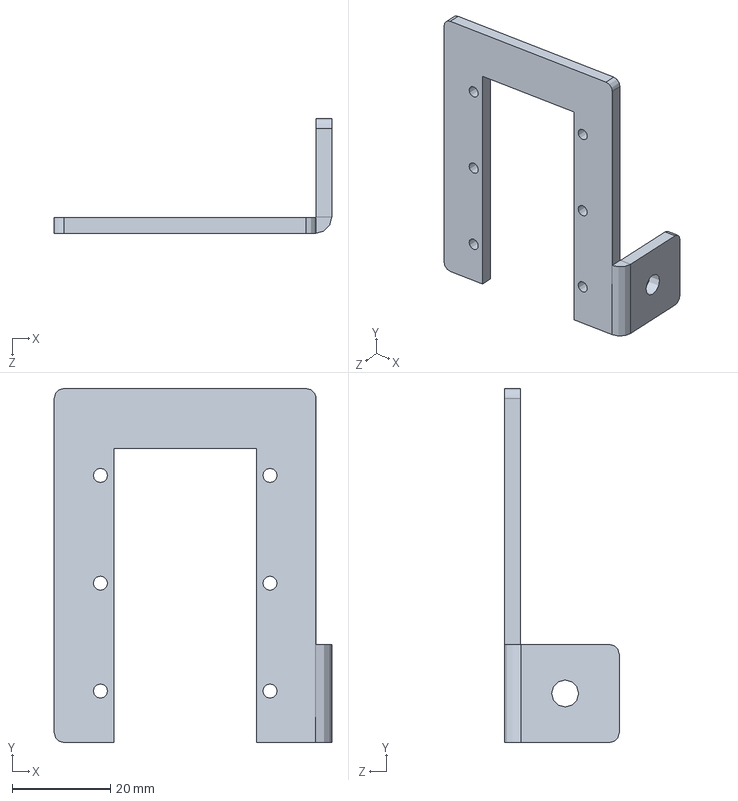
[picture p54: CAD file, 2015-11-13]
hardware/Parts/Hand/ServoMountArm.SLDPRT
56.6 x 72.2 x 23.4 mm
