eric-wieser/2.12-robot/hardware/Parts/Rail/IdlerPlate.sldprt

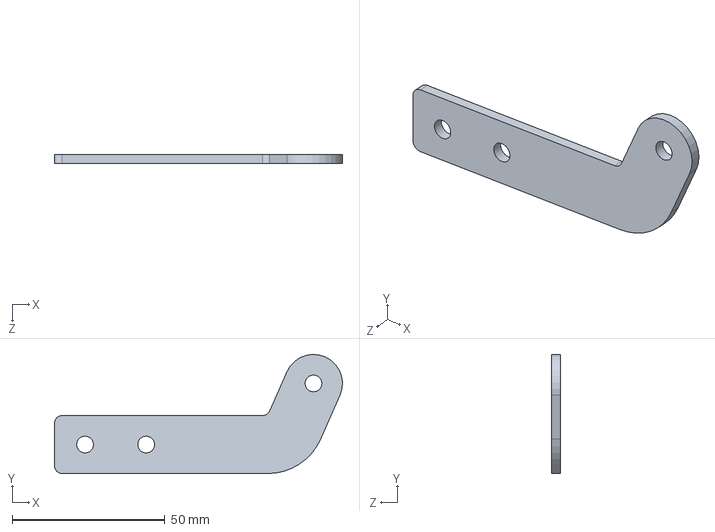
[picture p55: CAD file, 2015-12-03]
hardware/Parts/Rail/IdlerPlate.sldprt
94.2 x 39.0 x 3.00 mm
