eric-wieser/2.12-robot/hardware/Parts/Sifter/CorelDrawDXF/Hooks.DXF

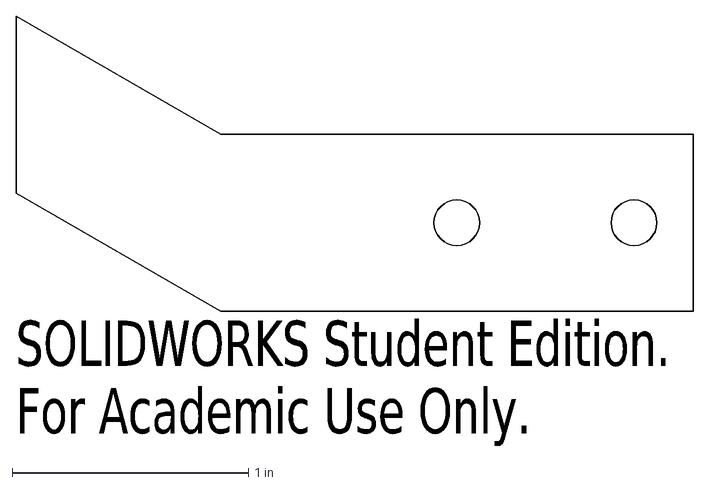
[picture p56: CAD file, 2015-11-13]
hardware/Parts/Sifter/CorelDrawDXF/Hooks.DXF
SOLIDWORKS Student Edition.
For Academic Use Only.
