eric-wieser/2.12-robot/hardware/Parts/Sifter/Hooks.SLDPRT

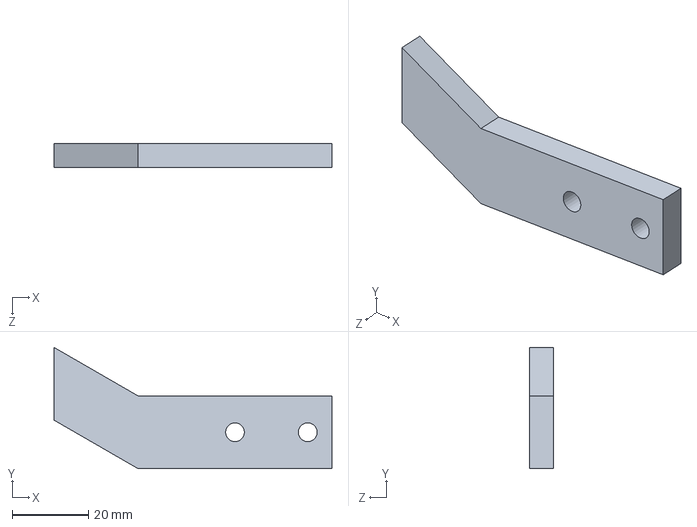
[picture p57: CAD file, 2015-11-13]
hardware/Parts/Sifter/Hooks.SLDPRT
72.8 x 31.8 x 6.35 mm
