eric-wieser/2.12-robot/hardware/Arena/Board.SLDPRT

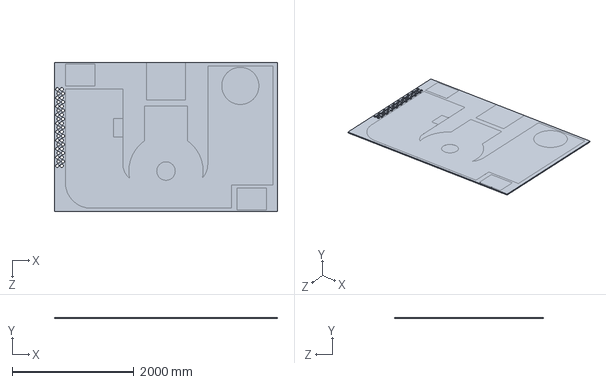
[picture p58: CAD file, 2015-10-30]
hardware/Arena/Board.SLDPRT
3657.6 x 19.3 x 2438.4 mm
