eric-wieser/2.12-robot/hardware/Parts/Hand/Hand_new/mounting_plate.SLDPRT

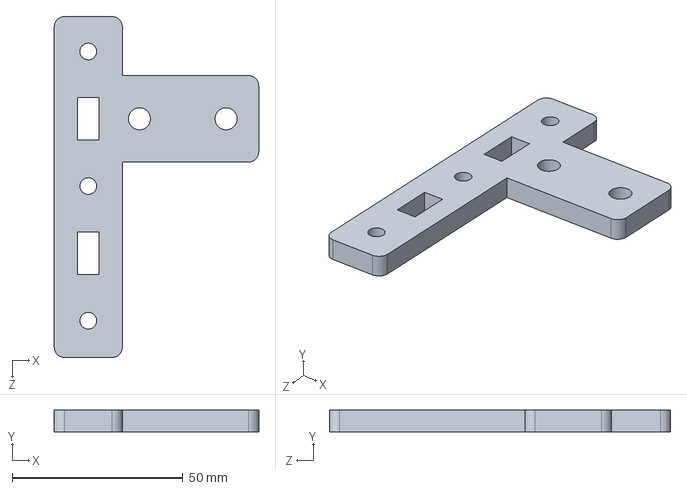
[picture p59: CAD file, 2015-12-03]
hardware/Parts/Hand/Hand_new/mounting_plate.SLDPRT
60.0 x 6.35 x 100.0 mm
