eric-wieser/2.12-robot/hardware/Parts/Hand/ServoHornLink2.SLDPRT

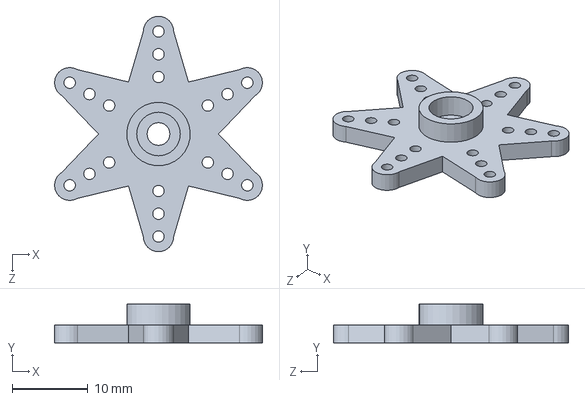
[picture p60: CAD file, 2015-11-11]
hardware/Parts/Hand/ServoHornLink2.SLDPRT
27.4 x 5.10 x 31.0 mm
