eric-wieser/2.12-robot/hardware/Parts/Sifter/CorelDrawDXF/Back_plate.DXF

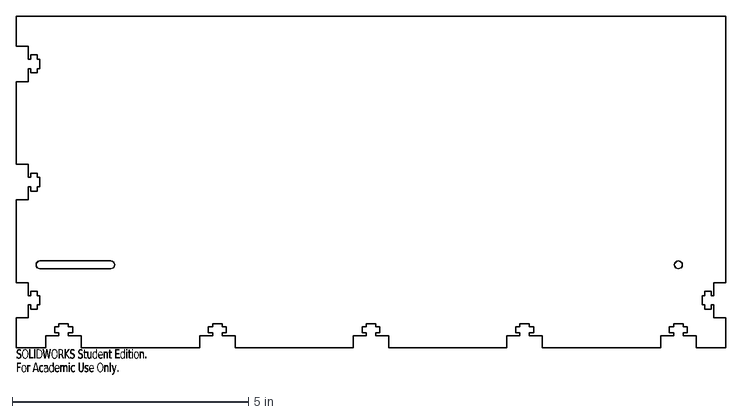
[picture p61: CAD file, 2015-11-13]
hardware/Parts/Sifter/CorelDrawDXF/Back_plate.DXF
SOLIDWORKS Student Edition.
For Academic Use Only.
