eric-wieser/2.12-robot/hardware/Parts/Sifter/Top_side_panel.SLDPRT

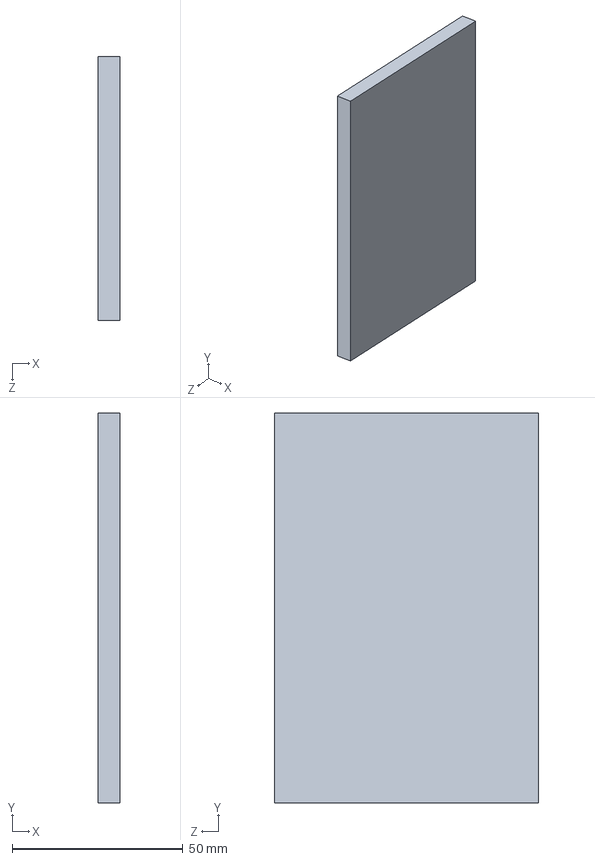
[picture p62: CAD file, 2015-11-13]
hardware/Parts/Sifter/Top_side_panel.SLDPRT
6.35 x 114.3 x 77.5 mm
