eric-wieser/2.12-robot/hardware/BaseRobot/KinectStandoff2.SLDPRT

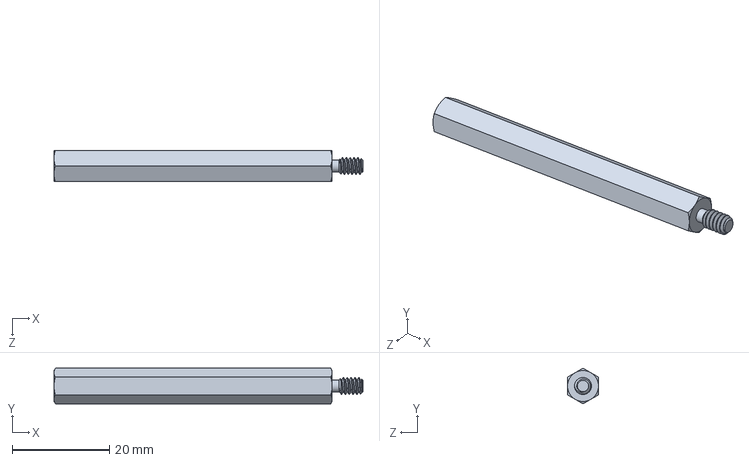
[picture p63: CAD file, 2015-11-02]
hardware/BaseRobot/KinectStandoff2.SLDPRT
63.5 x 7.33 x 6.35 mm
