eric-wieser/2.12-robot/hardware/Parts/Hand/Hand_new/HandLink1Mount.SLDPRT

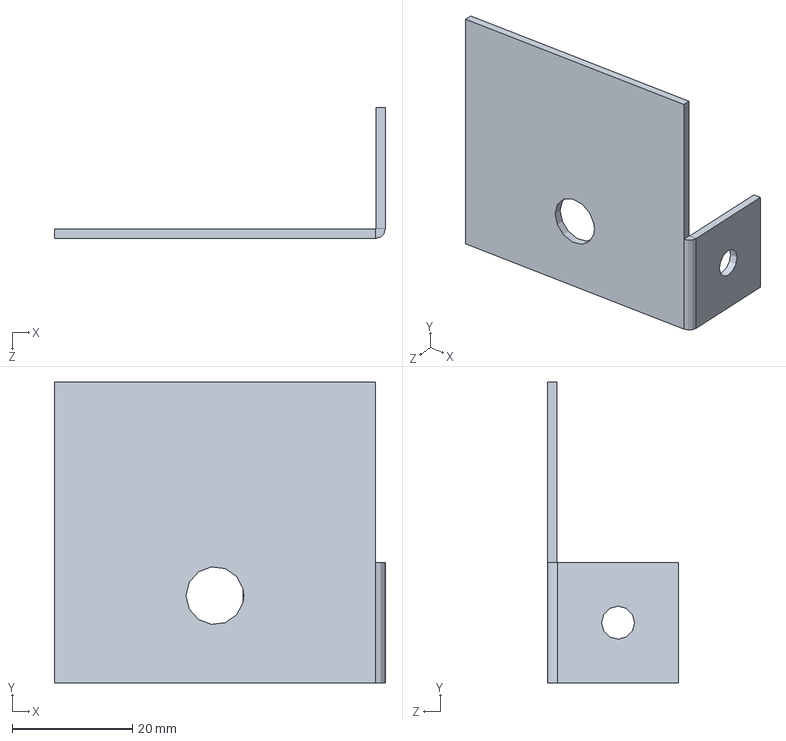
[picture p64: CAD file, 2015-12-03]
hardware/Parts/Hand/Hand_new/HandLink1Mount.SLDPRT
55.1 x 50.0 x 21.8 mm
