eric-wieser/2.12-robot/hardware/Parts/Rail/Pulley 30 tooth.SLDPRT

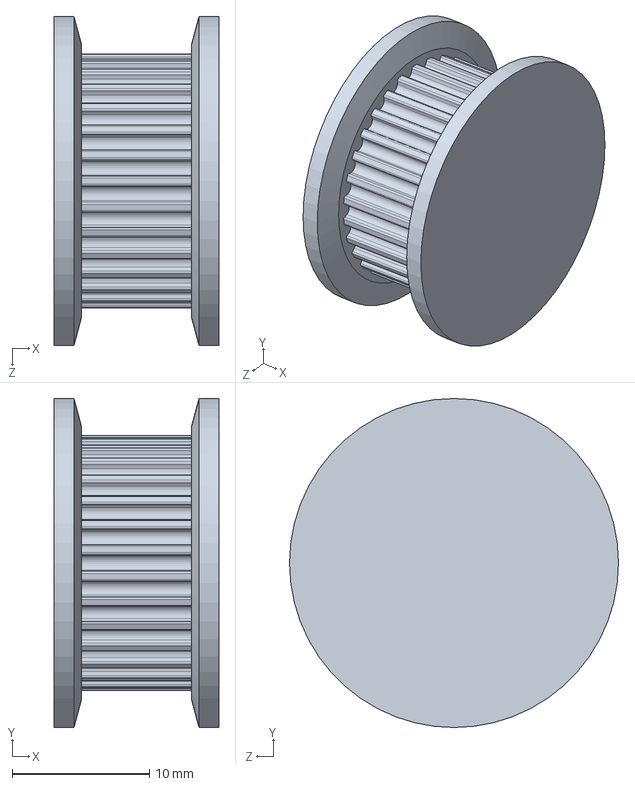
[picture p65: CAD file, 2015-11-05]
hardware/Parts/Rail/Pulley 30 tooth.SLDPRT
12.0 x 24.0 x 24.0 mm
