eric-wieser/2.12-robot/hardware/Parts/Sifter/Chicken_wire.SLDPRT

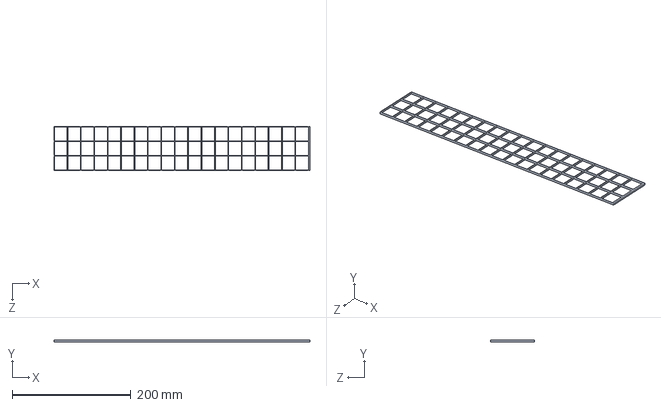
[picture p66: CAD file, 2015-11-02]
hardware/Parts/Sifter/Chicken_wire.SLDPRT
431.8 x 3.17 x 74.2 mm
