eric-wieser/2.12-robot/hardware/Parts/Sifter/CorelDrawDXF/Bottom_side_panel.DXF

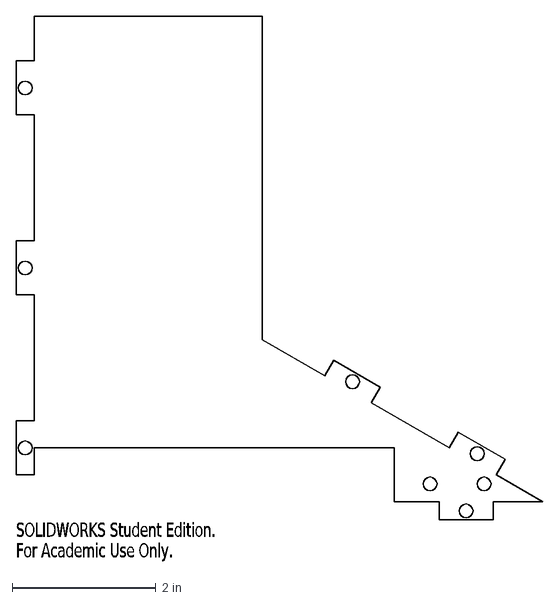
[picture p67: CAD file, 2015-11-13]
hardware/Parts/Sifter/CorelDrawDXF/Bottom_side_panel.DXF
SOLIDWORKS Student Edition.
For Academic Use Only.
