eric-wieser/2.12-robot/hardware/Arena/Wall.SLDPRT

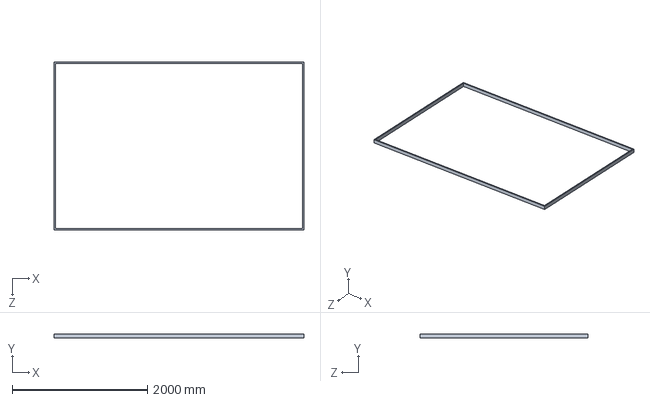
[picture p68: CAD file, 2015-10-30]
hardware/Arena/Wall.SLDPRT
3695.7 x 63.5 x 2476.5 mm
