eric-wieser/2.12-robot/hardware/BaseRobot/8020_corner.SLDPRT

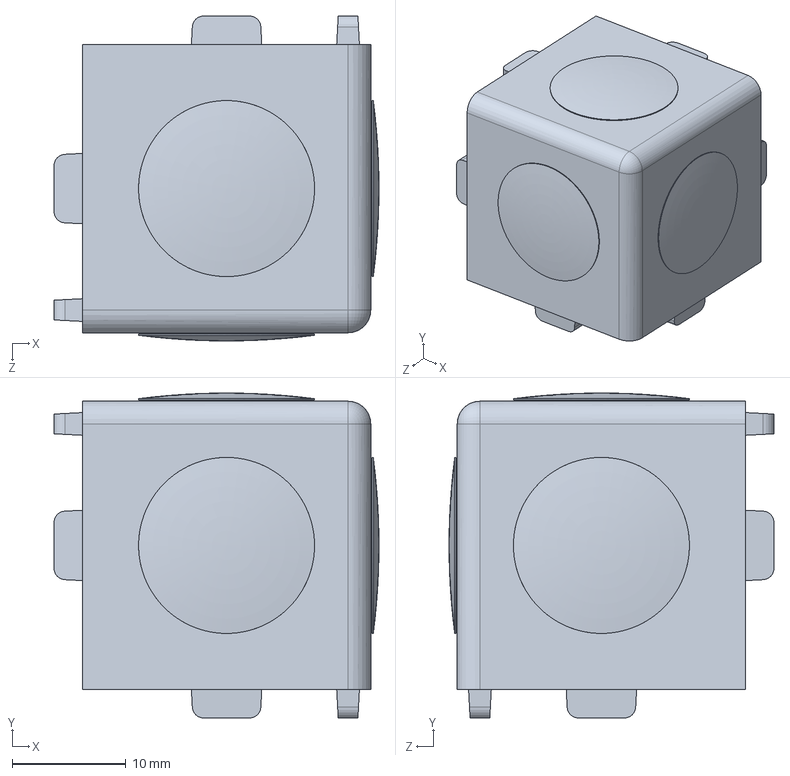
[picture p69: CAD file, 2015-11-02]
hardware/BaseRobot/8020_corner.SLDPRT
28.6 x 28.6 x 28.6 mm
