eric-wieser/2.12-robot/hardware/Parts/Hand/Hand_new/arm_mount.SLDPRT

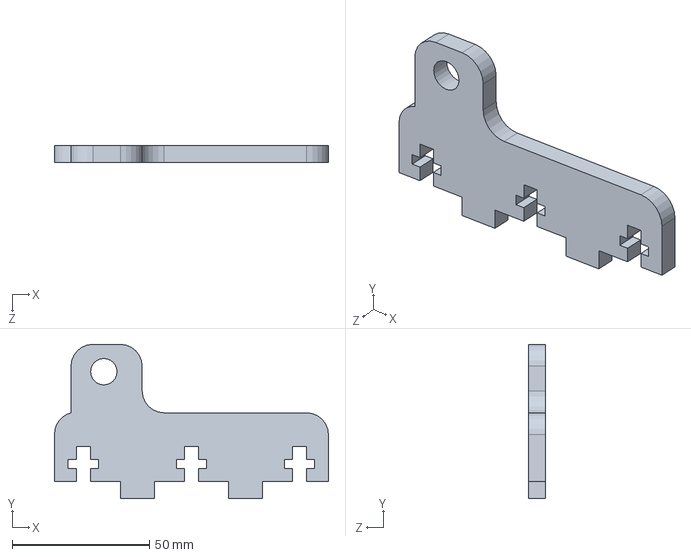
[picture p70: CAD file, 2015-12-03]
hardware/Parts/Hand/Hand_new/arm_mount.SLDPRT
100.0 x 56.4 x 6.35 mm
