eric-wieser/2.12-robot/hardware/Parts/Sifter/CorelDrawDXF/front_plate.DXF

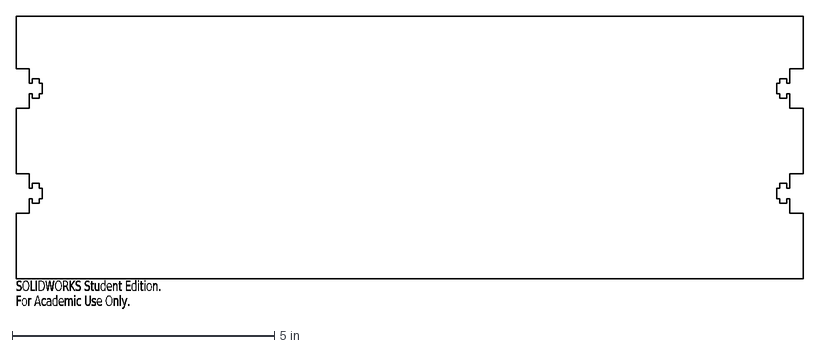
[picture p71: CAD file, 2015-11-13]
hardware/Parts/Sifter/CorelDrawDXF/front_plate.DXF
SOLIDWORKS Student Edition.
For Academic Use Only.
