eric-wieser/2.12-robot/hardware/Parts/Hand/Hand_new/Motor_mount_angled.SLDPRT

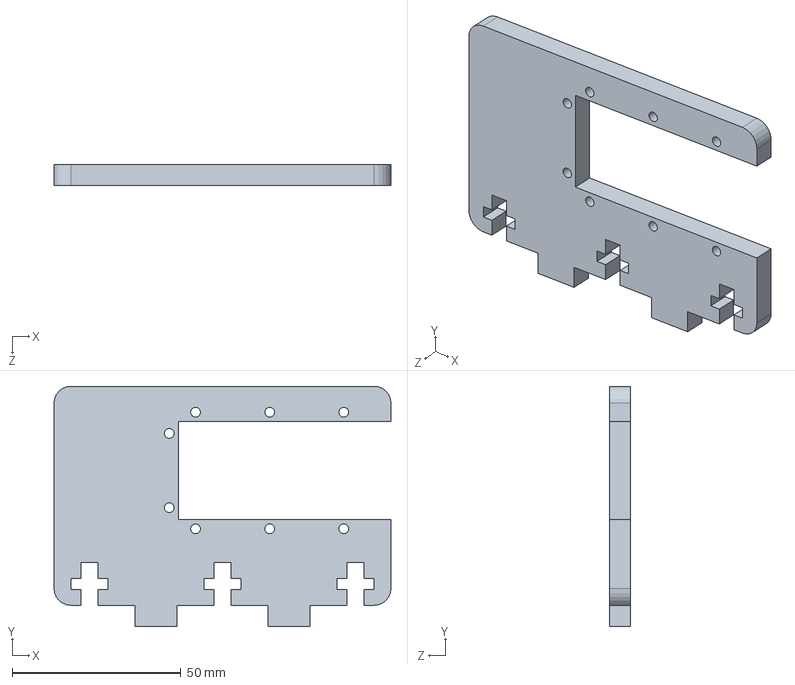
[picture p72: CAD file, 2015-12-03]
hardware/Parts/Hand/Hand_new/Motor_mount_angled.SLDPRT
100.0 x 71.3 x 6.35 mm
