eric-wieser/2.12-robot/hardware/Parts/Sifter/CorelDrawDXF/Bottom_plate.DXF

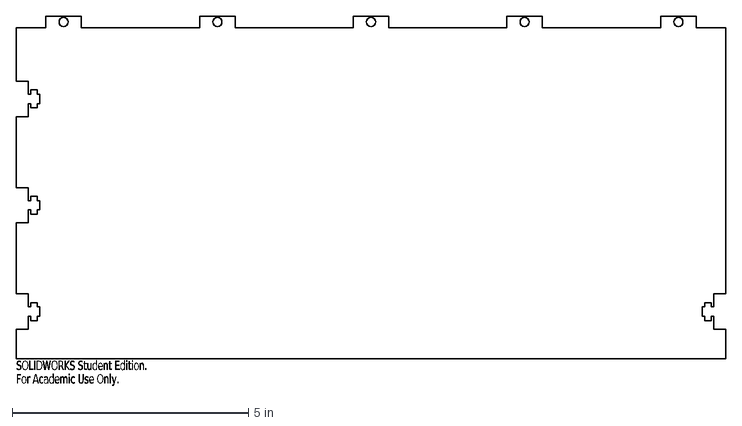
[picture p73: CAD file, 2015-11-13]
hardware/Parts/Sifter/CorelDrawDXF/Bottom_plate.DXF
SOLIDWORKS Student Edition.
For Academic Use Only.
