eric-wieser/2.12-robot/hardware/BaseRobot/ScreenHolder.SLDPRT

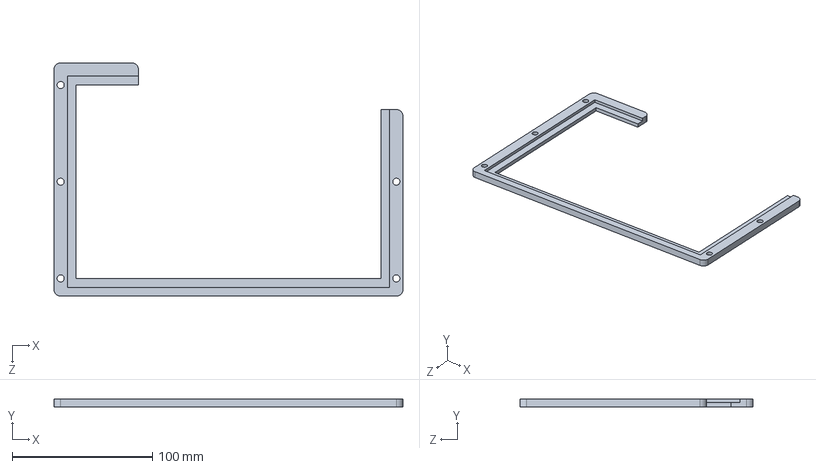
[picture p74: CAD file, 2015-11-02]
hardware/BaseRobot/ScreenHolder.SLDPRT
249.2 x 5.72 x 166.7 mm
