eric-wieser/2.12-robot/hardware/Parts/Hand/Hand_new/ServoMountArm.SLDPRT

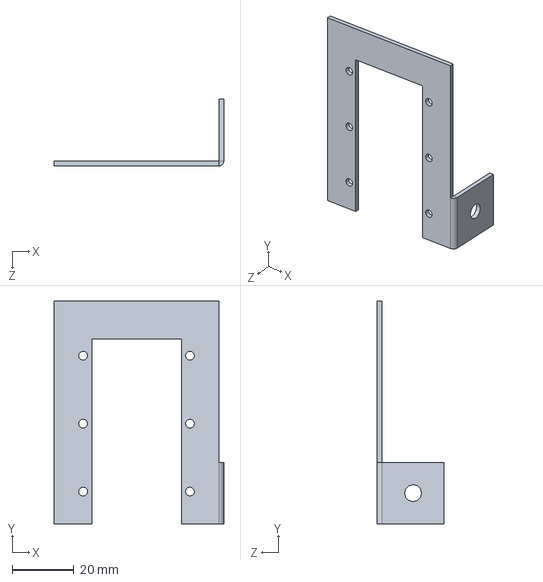
[picture p75: CAD file, 2015-12-02]
hardware/Parts/Hand/Hand_new/ServoMountArm.SLDPRT
55.1 x 72.2 x 21.8 mm
