eric-wieser/2.12-robot/hardware/BaseRobot/motor mounting plate.SLDPRT

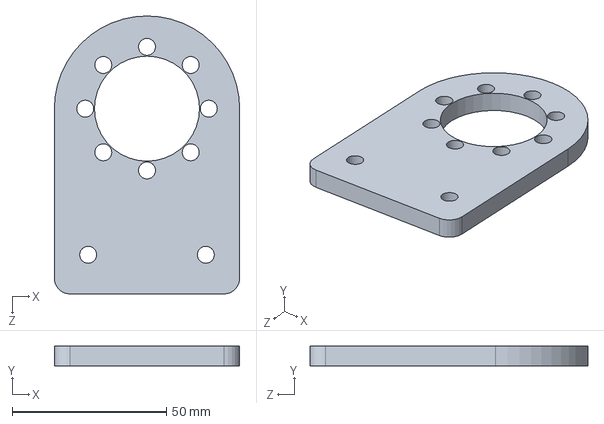
[picture p76: CAD file, 2015-11-02]
hardware/BaseRobot/motor mounting plate.SLDPRT
60.0 x 6.35 x 90.0 mm
