eric-wieser/2.12-robot/hardware/Parts/Hand/Hand_new/Scrapper.SLDPRT

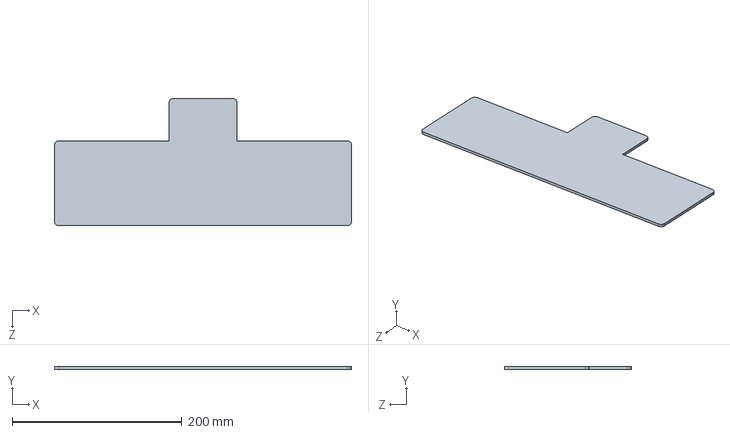
[picture p77: CAD file, 2015-12-02]
hardware/Parts/Hand/Hand_new/Scrapper.SLDPRT
350.0 x 3.17 x 150.0 mm
