eric-wieser/2.12-robot/hardware/BaseRobot/EncoderBufferBoard.SLDPRT

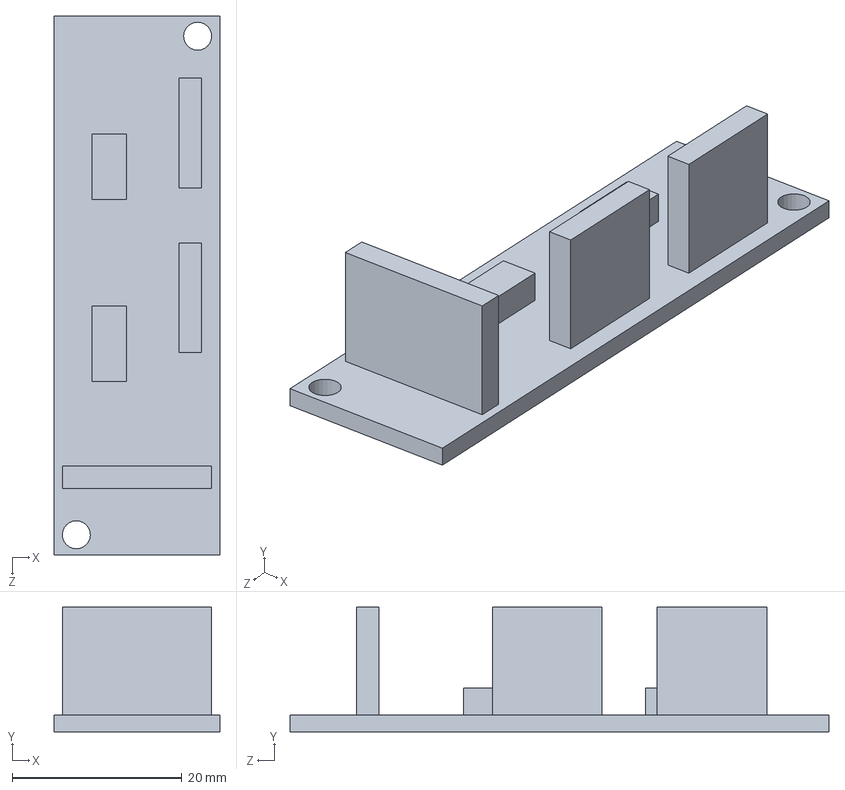
[picture p78: CAD file, 2015-11-02]
hardware/BaseRobot/EncoderBufferBoard.SLDPRT
19.6 x 14.7 x 63.5 mm
