eric-wieser/2.12-robot/hardware/BaseRobot/8020_extrusion.SLDPRT

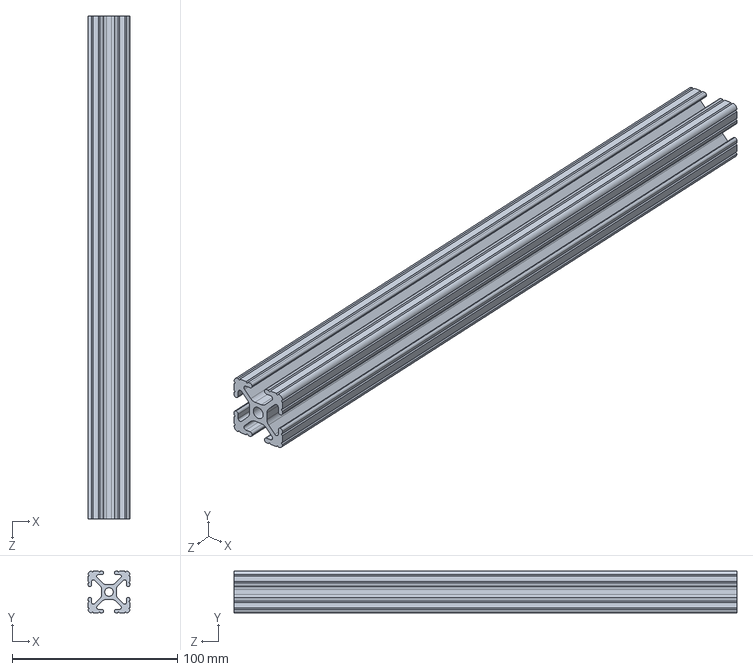
[picture p79: CAD file, 2015-11-02]
hardware/BaseRobot/8020_extrusion.SLDPRT
25.4 x 25.4 x 304.8 mm
