eric-wieser/2.12-robot/hardware/Parts/Hand/Hand_new/HandLink3_new.SLDPRT

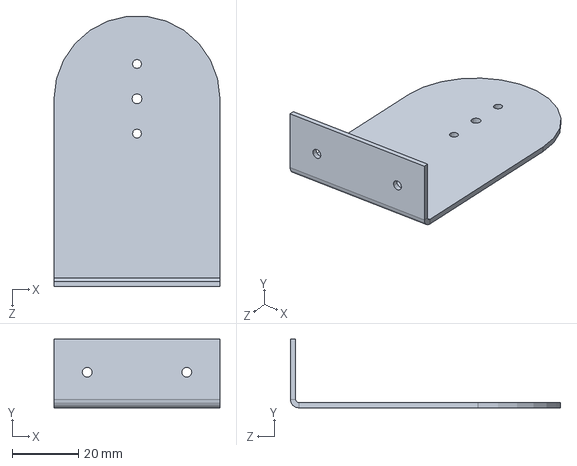
[picture p80: CAD file, 2015-12-01]
hardware/Parts/Hand/Hand_new/HandLink3_new.SLDPRT
50.0 x 20.8 x 81.4 mm
