eric-wieser/2.12-robot/hardware/BaseRobot/Kinect_Sensor.SLDPRT

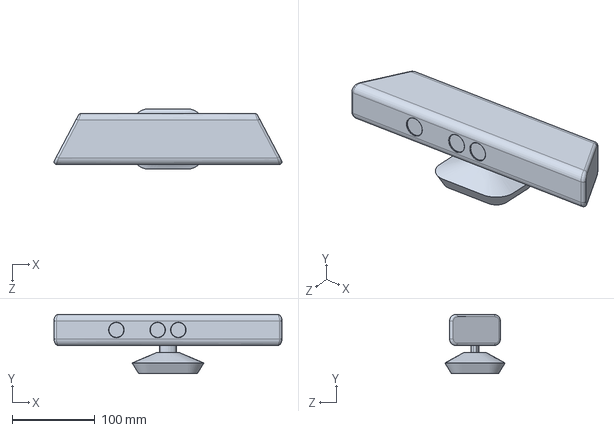
[picture p81: CAD file, 2015-11-02]
hardware/BaseRobot/Kinect_Sensor.SLDPRT
276.0 x 72.0 x 73.0 mm
