eric-wieser/2.12-robot/hardware/BaseRobot/PC.SLDPRT

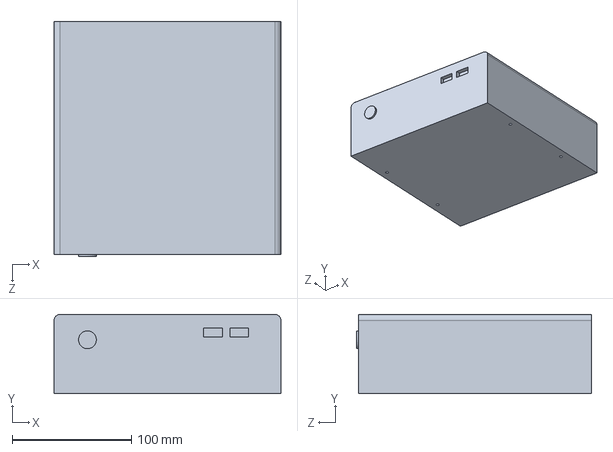
[picture p83: CAD file, 2015-11-02]
hardware/BaseRobot/PC.SLDPRT
190.0 x 66.2 x 197.0 mm
