eric-wieser/2.12-robot/hardware/Parts/Hand/Hand_new/HandLink1_new.SLDPRT

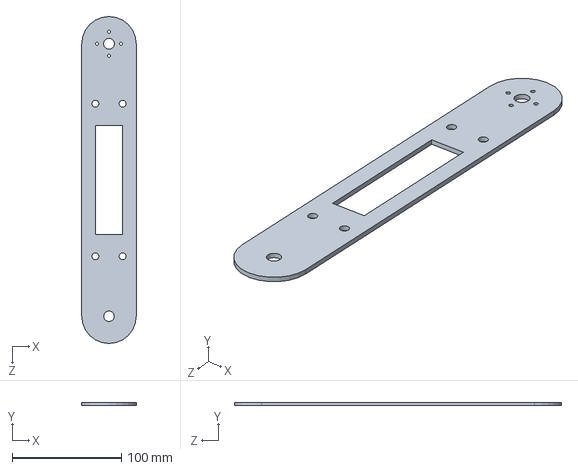
[picture p84: CAD file, 2015-12-01]
hardware/Parts/Hand/Hand_new/HandLink1_new.SLDPRT
50.0 x 3.17 x 300.0 mm
