eric-wieser/2.12-robot/hardware/BaseRobot/IG52-04.SLDPRT

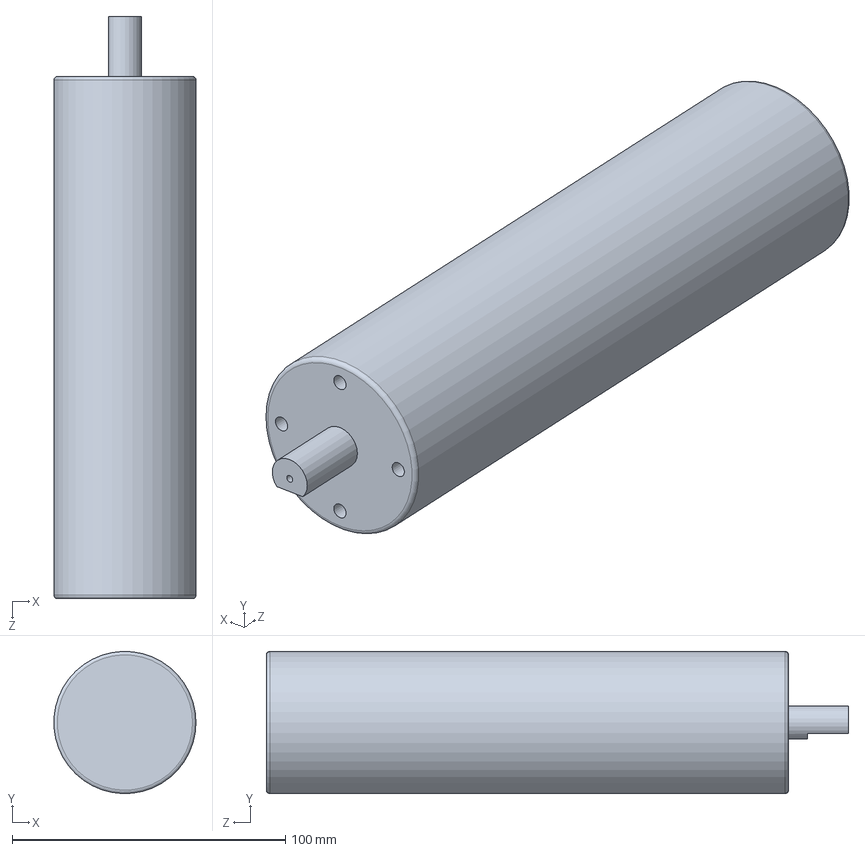
[picture p85: CAD file, 2015-11-02]
hardware/BaseRobot/IG52-04.SLDPRT
51.9 x 52.0 x 213.0 mm
