eric-wieser/2.12-robot/hardware/Parts/Hand/Hand_new/HandLink2_2_new.SLDPRT

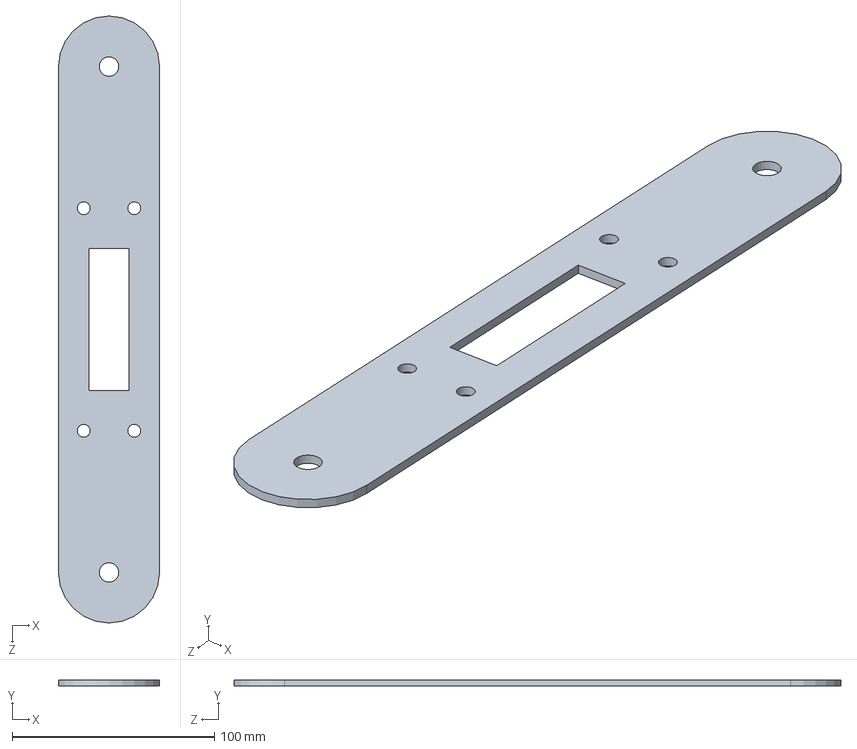
[picture p86: CAD file, 2015-12-01]
hardware/Parts/Hand/Hand_new/HandLink2_2_new.SLDPRT
50.0 x 3.17 x 300.0 mm
