eric-wieser/2.12-robot/hardware/Parts/Hand/Hand_new/HandLink2_new_vs_11.SLDPRT

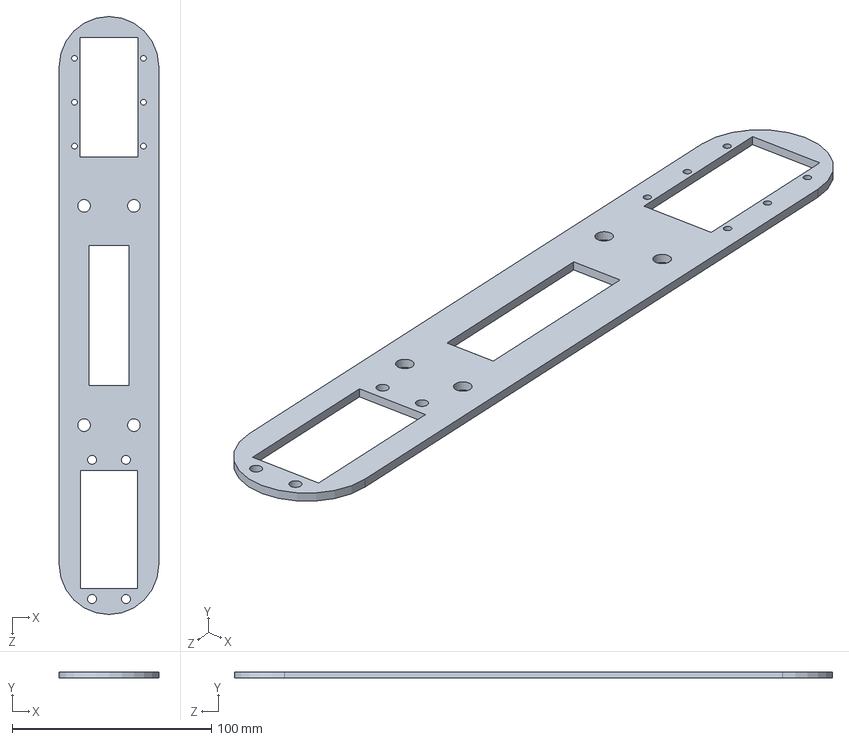
[picture p87: CAD file, 2015-12-01]
hardware/Parts/Hand/Hand_new/HandLink2_new_vs_11.SLDPRT
50.0 x 3.17 x 300.0 mm
