eric-wieser/2.12-robot/hardware/BaseRobot/KinectStandoff.SLDPRT

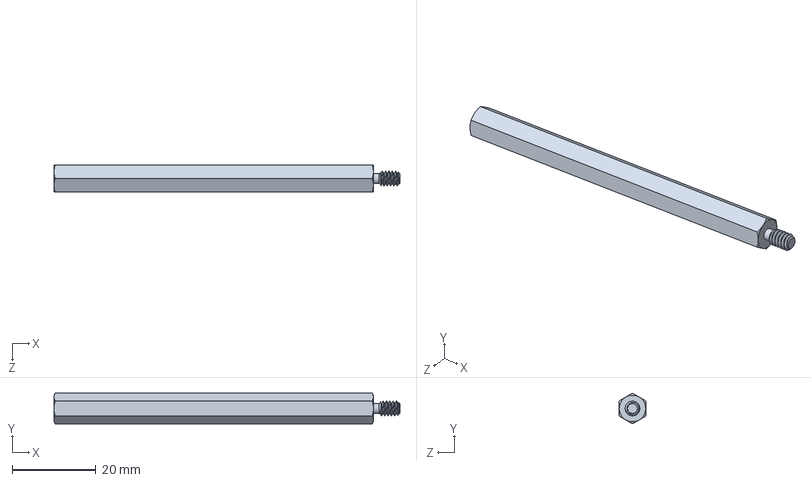
[picture p88: CAD file, 2015-11-02]
hardware/BaseRobot/KinectStandoff.SLDPRT
82.5 x 7.33 x 6.35 mm
