eric-wieser/2.12-robot/hardware/Parts/Hand/Hand_new/HandLink2_new.SLDPRT

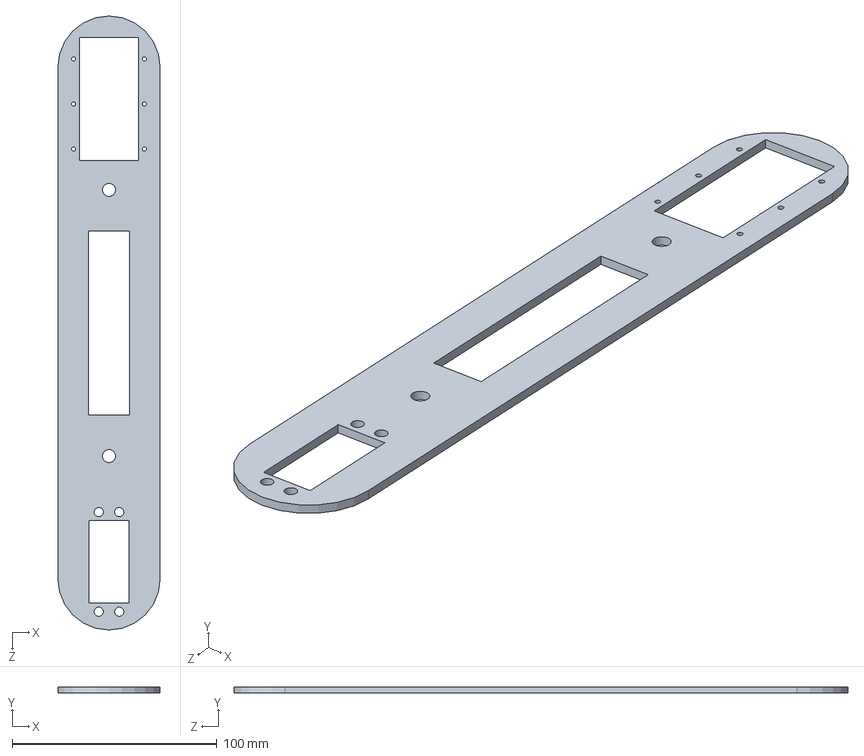
[picture p89: CAD file, 2015-11-22]
hardware/Parts/Hand/Hand_new/HandLink2_new.SLDPRT
50.0 x 3.17 x 300.0 mm
