eric-wieser/2.12-robot/hardware/BaseRobot/BaseStandoff.SLDPRT

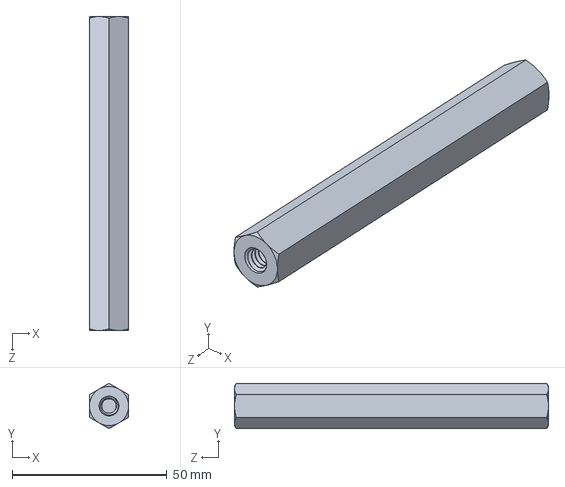
[picture p90: CAD file, 2015-11-02]
hardware/BaseRobot/BaseStandoff.SLDPRT
12.7 x 14.7 x 101.6 mm
