eric-wieser/2.12-robot/hardware/Parts/Hand/Hand_new/LinkingBar.SLDPRT

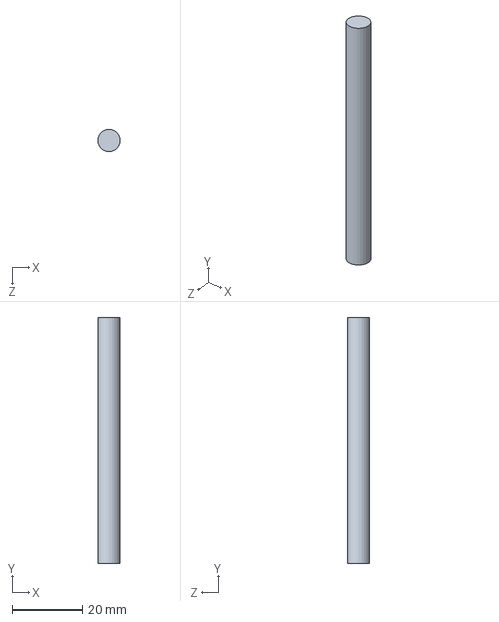
[picture p91: CAD file, 2015-11-22]
hardware/Parts/Hand/Hand_new/LinkingBar.SLDPRT
6.35 x 70.0 x 6.35 mm
