eric-wieser/2.12-robot/hardware/Parts/Hand/Hand_new/LinkingBar2.SLDPRT

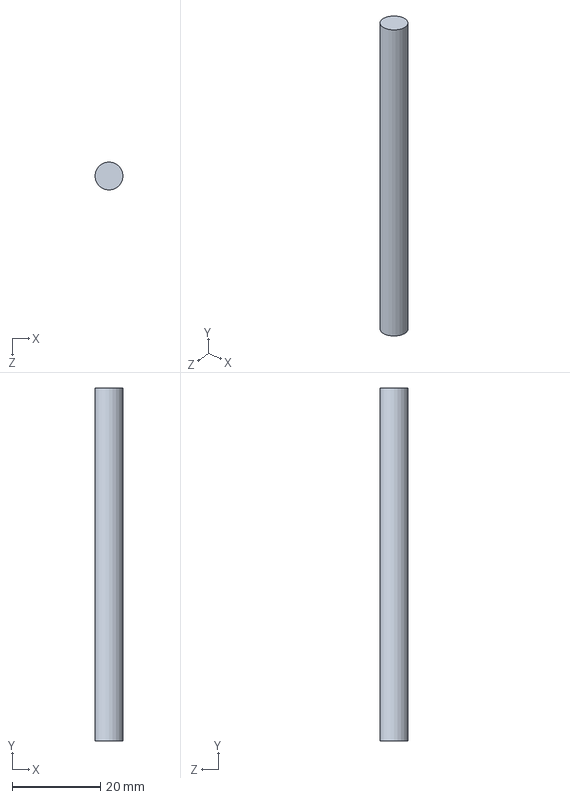
[picture p92: CAD file, 2015-11-22]
hardware/Parts/Hand/Hand_new/LinkingBar2.SLDPRT
6.35 x 80.0 x 6.35 mm
