eric-wieser/2.12-robot/hardware/BaseRobot/ScreenBoard.SLDPRT

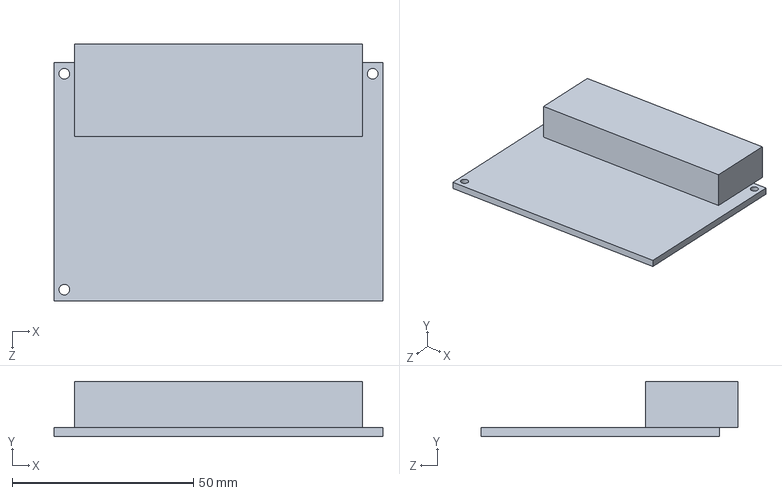
[picture p93: CAD file, 2015-11-02]
hardware/BaseRobot/ScreenBoard.SLDPRT
90.7 x 15.2 x 70.8 mm
