eric-wieser/2.12-robot/hardware/BaseRobot/wheel_basic.SLDPRT

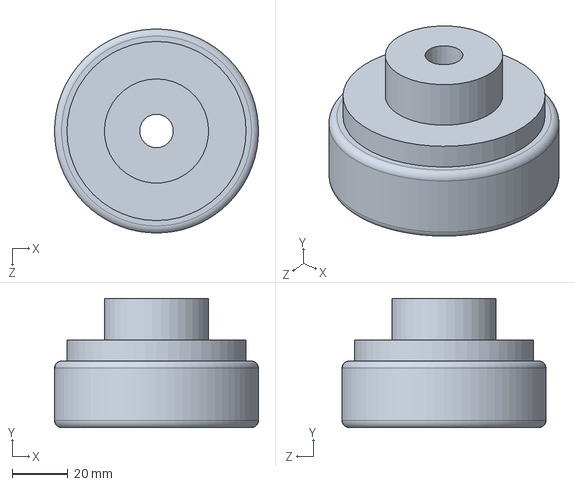
[picture p94: CAD file, 2015-11-02]
hardware/BaseRobot/wheel_basic.SLDPRT
73.4 x 46.5 x 73.4 mm
