eric-wieser/2.12-robot/hardware/BaseRobot/VDC1.SLDPRT

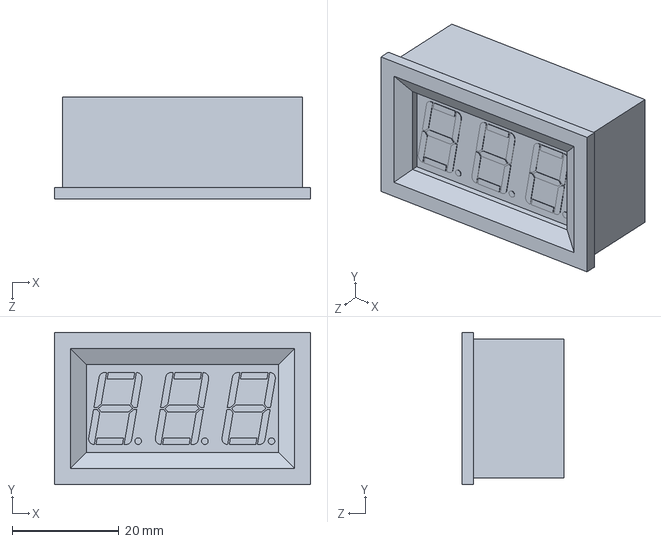
[picture p95: CAD file, 2015-11-02]
hardware/BaseRobot/VDC1.SLDPRT
48.0 x 28.5 x 19.2 mm
