eric-wieser/2.12-robot/hardware/BaseRobot/Screen.SLDPRT

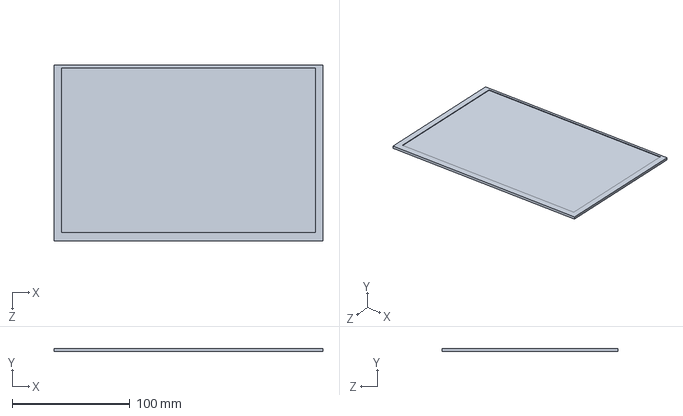
[picture p96: CAD file, 2015-11-02]
hardware/BaseRobot/Screen.SLDPRT
228.6 x 2.54 x 149.2 mm
