eric-wieser/2.12-robot/hardware/BaseRobot/KinectRGBFOV.SLDPRT

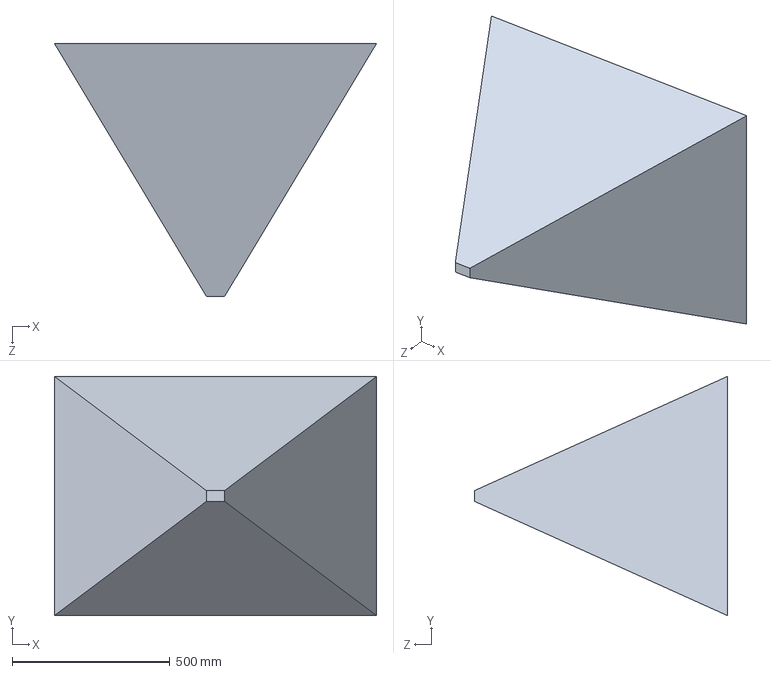
[picture p97: CAD file, 2015-11-02]
hardware/BaseRobot/KinectRGBFOV.SLDPRT
1019.6 x 756.9 x 800.0 mm
