eric-wieser/2.12-robot/hardware/BaseRobot/RobotTopPlatform_ZACK_EDIT.SLDPRT

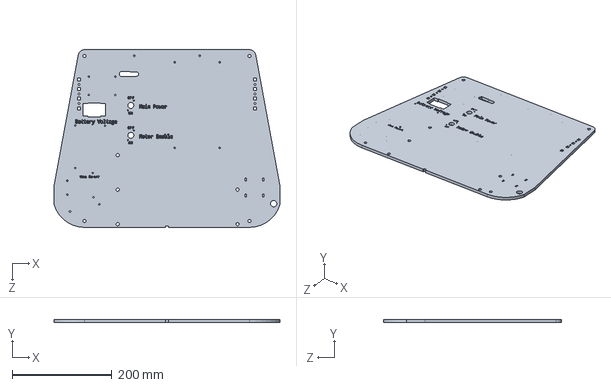
[picture p98: CAD file, 2015-11-02]
hardware/BaseRobot/RobotTopPlatform_ZACK_EDIT.SLDPRT
452.1 x 6.35 x 355.6 mm
