eric-wieser/2.12-robot/hardware/BaseRobot/DROK DCDC.SLDPRT

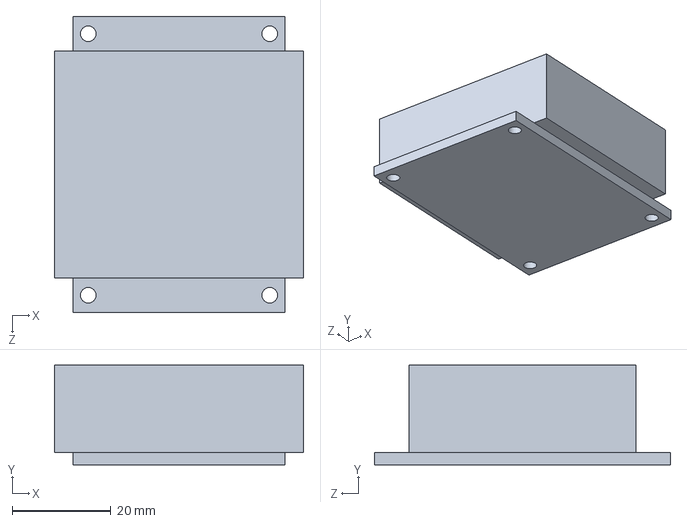
[picture p99: CAD file, 2015-11-02]
hardware/BaseRobot/DROK DCDC.SLDPRT
50.5 x 20.2 x 60.0 mm
