eric-wieser/2.12-robot/hardware/BaseRobot/Arduino UNO.SLDPRT

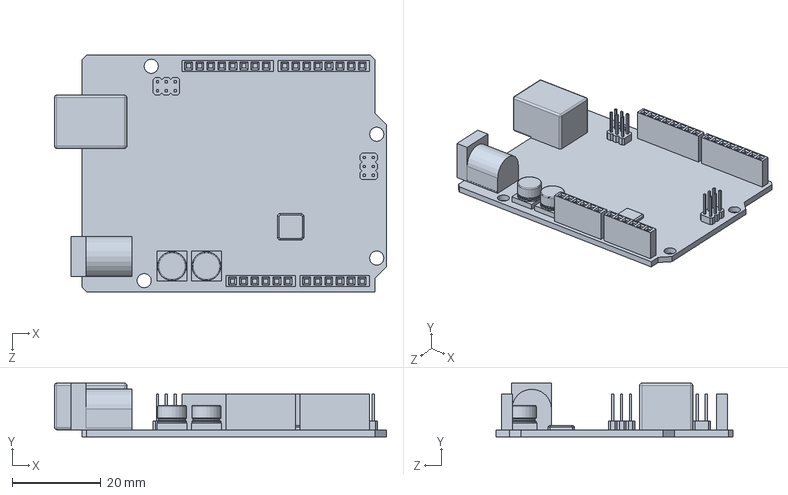
[picture p100: CAD file, 2015-11-02]
hardware/BaseRobot/Arduino UNO.SLDPRT
74.8 x 12.1 x 53.3 mm
