eric-wieser/2.12-robot/hardware/BaseRobot/Kinect shelf plate.SLDPRT

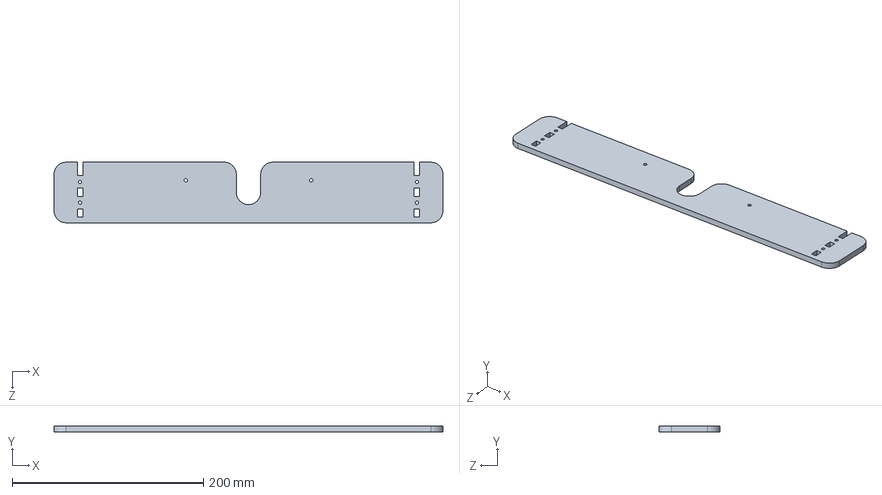
[picture p101: CAD file, 2015-11-02]
hardware/BaseRobot/Kinect shelf plate.SLDPRT
406.4 x 6.00 x 63.5 mm
