eric-wieser/2.12-robot/hardware/BaseRobot/RobotTopPlatformV2.DXF

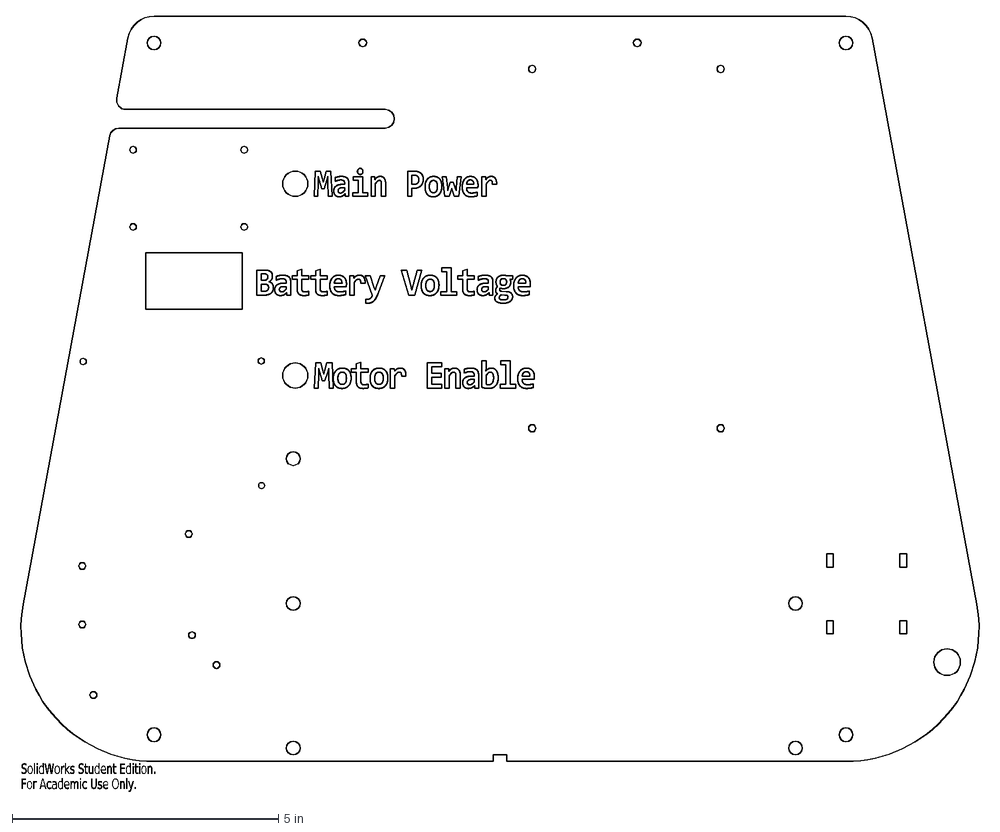
[picture p102: CAD file, 2015-11-02]
hardware/BaseRobot/RobotTopPlatformV2.DXF
SolidWorks Student Edition.
For Academic Use Only.
