eric-wieser/2.12-robot/(list of files, cad)

Other CAD files:
hardware/Parts/Rail/Trolley.sldasm
hardware/Parts/Rail/MirrorRail.SLDASM
hardware/BaseRobot/Switch/DEFAULT.sldasm
hardware/BaseRobot/Switch/DEFAULT-4.sldprt
hardware/BaseRobot/Switch/DEFAULT-7.sldprt
hardware/BaseRobot/TPLink/zapt.sldprt
hardware/BaseRobot/Switch/DEFAULT-2.sldprt
hardware/BaseRobot/TPLink/wireless.sldprt
hardware/BaseRobot/TPLink/wireless2.sldprt
hardware/BaseRobot/Switch/DEFAULT-5.sldprt
hardware/Parts/Hand/Hand_new/Servo-Scraper_link.SLDPRT
hardware/BaseRobot/Switch/DEFAULT-6.sldprt
hardware/BaseRobot/Switch/DEFAULT-3.sldprt
hardware/BaseRobot/Switch/DEFAULT-1.sldprt
hardware/BaseRobot/6-32Screw.SLDPRT
hardware/BaseRobot/6-32x0_625 T-Nut BLOCK.SLDBLK.SLDPRT
hardware/BaseRobot/6-32x0_625 T-Nut.SLDPRT
hardware/BaseRobot/6-32x0_75 T-Nut.SLDPRT
hardware/BaseRobot/IG520053-SY3465.SLDPRT
hardware/BaseRobot/Kinect shelf plate.DXF
hardware/BaseRobot/RobotTopPlatform_ZACK_EDIT.DXF
hardware/BaseRobot/ScreenHolder.STL
hardware/BaseRobot/Switch/DEFAULT.sldprt
hardware/BaseRobot/TopAssembly_old.SLDASM
hardware/BaseRobot/kinect shelf side panel.DXF
hardware/Parts/Hand/Hand_new/Motor_mount_angled.DXF
hardware/Parts/Hand/Hand_new/Scraper_acrylic.DXF
hardware/Parts/Hand/Hand_new/Servo-Scraper_link.DXF
hardware/Parts/Hand/Hand_new/Servo-arm-link.DXF
hardware/Parts/Hand/Hand_new/Sheet2.SLDDRW
hardware/Parts/Hand/Hand_new/Sheet3_mounts.SLDDRW
hardware/Parts/Hand/Hand_new/Sheet4_scrapper.SLDDRW
hardware/Parts/Hand/Hand_new/arm_mount.DXF
hardware/Parts/Hand/Hand_new/motor_mount_large.DXF
hardware/Parts/Hand/Hand_new/mounting_plate.DXF
hardware/Parts/Rail to Frame/47065T147 End feed fastener screws.SLDPRT
hardware/Parts/Rail to Frame/47065T147 End feed fastener without screws.SLDPRT
hardware/Parts/Rail to Frame/47065T147 End feed fastener.SLDPRT
hardware/Parts/Rail to Frame/47065T209.SLDPRT
hardware/Parts/Rail to Frame/47065T209bis.SLDPRT
hardware/Parts/Rail to Frame/47065T209ter.SLDPRT
hardware/Parts/Rail to Frame/47065T236.SLDPRT
hardware/Parts/Rail to Frame/47065T255.SLDPRT
hardware/Parts/Rail to Frame/47065T313.SLDPRT
hardware/Parts/Rail to Frame/47065T411.SLDPRT
hardware/Parts/Rail to Frame/47065T411bis.SLDPRT
hardware/Parts/Rail to Frame/47065T411ter.SLDPRT
hardware/Parts/Rail to Frame/5537T315.SLDPRT
hardware/Parts/Rail to Frame/5537T441.SLDPRT
hardware/Parts/Rail/IdlerPlate.DXF
hardware/Sheet1.DXF
hardware/Sheet1.SLDDRW
hardware/Sheet2.SLDDRW
