eric-wieser/2.12-robot/(threads)

Thread 16 (2015-11-05):

Are we sure the small motors will be up to moving the arm?

eric-wieser, 2015-11-05:
I think we could get away with the small ones on the rail, which would give us the bonus of a speed increase there, and leave the big ones to operate the arm

eric-wieser, 2015-12-01:
We're using the 106s now, due to being allowed to. Whether we should use the small motors for the rail is a separate issue

Closed 2015-12-01.

Thread 26 (2015-11-13):

Create sheetmetal layout for arm

eric-wieser, 2015-11-13:
Involves adding a configuration to each link

eric-wieser, 2015-12-01:
Todo: Create such a layout for the motor mounts

premphy, 2015-12-01:
Arm sheet lay out is under Sheet2, Mount lay out is under Sheet3_mounts. The aluminium sheet for mounts will be in lab by 10am.

premphy, 2015-12-01:
Wait until 10 am. Will add scraper as well.

Thread 29 (2015-11-14):

Fix sifter slot and hole

eric-wieser, 2015-11-14:
While we're at it, some small holes in the back to attach chicken wire to would be handy

And maybe reduce the guard height to 2 or 3 inches

14kirchm, 2015-11-29:
The sifter fell into pieces. We'll nee a new one pretty soon !

14kirchm, 2015-11-29:
Weak part

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

14kirchm, 2015-11-29:
3 pieces to repair

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

reaganm, 2015-11-29:
I can lasercut the new and improved sifter tonight if I can get into MITERs
past midnight.  Otherwise we'll have to wait until tomorrow night.

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

eric-wieser, 2015-11-29:
Did you ever commit this new and improved sifter?

reaganm, 2015-11-29:
Yes, it should be the one that is in the repository.  The only thing I had
planned on changing was filleting the top corners.

On Sun, Nov 29, 2015 at 5:43 PM, Eric Wieser <notifications@github.com>
wrote:

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

reaganm, 2015-11-29:
Just added some lasercutter files, but the solidworks files should be
unchanged

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

eric-wieser, 2015-11-29:
Do we thing #49 is fixable with how this is cut, or is that going to have to be fixed another way?

reaganm, 2015-11-29:
I think ideally we'd want something bendy that we can use as a guide ramp
or something (like paper or cardboard) that would not catch on the dump
truck as the sifter is being lifted, so probably not acrylic-- though I can
cut cardboard on the laser cutter also.

On Sun, Nov 29, 2015 at 5:50 PM, Eric Wieser <notifications@github.com>
wrote:

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

eric-wieser, 2015-11-29:
Drilling some small mounting holes for cable-tying cardboard on might be a good use of laser-cutter

eric-wieser, 2015-11-29:
"drilling"

reaganm, 2015-11-29:
Okay, I can add some small mounting holes on the open side.

On Sun, Nov 29, 2015 at 6:03 PM, Eric Wieser <notifications@github.com>
wrote:

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

reaganm, 2015-12-01:
fixed when new sifter was lasercut

Closed 2015-12-01.

Thread 40 (2015-11-20):

Verify correctness of drive motor and encoder wiring

eric-wieser, 2015-11-20:

eric-wieser, 2015-11-23:
There are now a bunch of functions in `tests.cpp` that do these things. Wiring is all correct now.

Closed 2015-11-23.

Thread 41 (2015-11-20):

Use GPS to drive the robot to mount simmons

eric-wieser, 2015-11-20:

eric-wieser, 2015-11-24:
#47 added the infrastructure needed for matlab and the arduino to communicate this data

eric-wieser, 2015-12-02:
The robot now replaces its location estimate with data it gets over GPS. It should probably only do this when still...

Thread 42 (2015-11-20):

Write code to control the rail dynamixels

eric-wieser, 2015-11-20:
See `software/Dynamixel config.txt` for details on some of the complexities here

eric-wieser, 2015-11-24:
Update: we can now connect to them - the issue was that they had different baud rates, and clashing ID numbers. The one on robot-right is now id 1, and the one on robot left is id 2

eric-wieser, 2015-11-24:
Both are at a baud rate of 400000

14kirchm, 2015-11-24:
Ok, great news. I'm going to lab tomorrow to write the code and see if they are able to rotate more than 1 turn unless you were already working on this ?

eric-wieser, 2015-11-24:
they can rotate more than one turn, but we need to be careful how we configure them (torque limits, etc). I don't plan to work on this - I thought I'd just debug the connection while there was someone else having the same issue.

14kirchm, 2015-11-24:
Ok sounds good. I just need to add the torque limit, angle limits and the Resolution Divider issue to the code uploaded for lab4 correct ?

eric-wieser, 2015-11-24:
I mean, most of lab4 was inverse kinematics, which is irrelevant here. Change whichever settings you think make the lifter behave most sensibly. You might find you need to tension the belts to get them not to slip - there are some tensioning springs in the box.

14kirchm, 2015-11-24:
Ok I'll take a look

eric-wieser, 2015-12-02:
I think we're good here, software-wise

Closed 2015-12-02.

Thread 43 (2015-11-20):

Write code to control the arm

eric-wieser, 2015-11-20:
Either inverse dynamics or inverse kinematics - one requires us to use the torque control, rather than position control.

eric-wieser, 2015-12-02:
I've added some skeleton code to this (`Arm.m`) - can someone else flesh it out?

Take a look at `main.m` to see how to test it

reaganm, 2015-12-02:
I am working on this.

On Tue, Dec 1, 2015 at 9:10 PM, Eric Wieser <notifications@github.com>
wrote:

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

Thread 44 (2015-11-21):

Round off sharp corners on sifter back

eric-wieser, 2015-11-21:
Oww

If the new parts aren't laser cut yet, can we add some fillets to the outwards-facing corners?

reaganm, 2015-12-01:
forgot to do this, so we'll have to live with it

Closed 2015-12-01.

Thread 45 (2015-11-21):

Encoder board does not work

eric-wieser, 2015-11-21:
Only one of the two encoders gives back values over a range larger than {0, -1}. Suspect a bad solder joint

eric-wieser, 2015-11-21:
Fixed by resoldering

Closed 2015-11-21.

Thread 47 (2015-11-23):

Add messages to arduino protocol

eric-wieser, 2015-11-23:
* [ ] to control VS11 servo
* [ ] to update information from GPS
* [ ] heartbeat for motor shutoff?

Closed 2015-11-24.

Thread 48 (2015-11-24):

Add endpoint servo interface code

eric-wieser, 2015-11-24:
Configure pwm etc. Desired angle is in `reportData.servoGoal`

eric-wieser, 2015-11-24:
(assigned to @premphy because he currently has the servo)

eric-wieser, 2015-11-30:
@premphy, can you get this servo into the lab ASAP?

eric-wieser, 2015-12-02:
Update from this morning's lab - held up by a lack of wiring

eric-wieser, 2015-12-02:
I've added a test for this - once you've got it working and updated `VS11.h` and `VS11.cpp`, you can add `tests::servo()` to init() in `embedded.ino`

Closed 2015-12-03.

Thread 49 (2015-11-29):

Find a way to put snow in dumptruck

14kirchm, 2015-11-29:
Gap between dump truck and sifter. The snow doesn't go into the truck

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

eric-wieser, 2015-11-29:
Cardboard? Paper?

reaganm, 2015-12-01:
Relatedly: should I re-lasercut the servo mounts to be taller so that we can increase the tilt angle? Or did we just decide to use a weight as the solution?

eric-wieser, 2015-12-02:
May as well do that, and swap the motor mounts for the MX64s as well

eric-wieser, 2015-12-02:
I think using a weight will be hard to get right
And doesn't work for the debris (which is actually heavier than what we tested with)

reaganm, 2015-12-02:
Working on this now, will be back in lab soon.
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

Thread 50 (2015-11-30):

Make 6-slide presentation

eric-wieser, 2015-11-30:
By midnight tomorrow

eric-wieser, 2015-11-30:
(can be modified after initial submission)

simpri21, 2015-12-01:
are the slides just about how the robot does each of its tasks (navigating, picking up snow, dumping snow, picking up tree, clearing roof)? I can work on this

eric-wieser, 2015-12-01:
I think that's most of it, yeah

eric-wieser, 2015-12-02:
I've got a couple of photos of the sifter doing things, that I'll put on google drive in a few minutes

eric-wieser, 2015-12-02:
Photos are up, although maybe a rendering would be better. Were you not able to render the sifter in the up position?

simpri21, 2015-12-02:
Working on it now, its gonna be done very last minute
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

eric-wieser, 2015-12-02:
I just updated the cad. It was wrong

simpri21, 2015-12-02:
I'm doing as is for now cuz each render takes about 30 min, I can remake
them on thursday
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

simpri21, 2015-12-02:
Saved what I have for now, will remake once everything's finalized

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

eric-wieser, 2015-12-02:
Did we get this on the dropbox?

simpri21, 2015-12-02:
If you haven't checked already, yes I saved it on there

On Wed, Dec 2, 2015 at 12:13 AM, Eric Wieser <notifications@github.com>
wrote:

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

eric-wieser, 2015-12-02:
Great

premphy, 2015-12-02:
Were you able to waterjet parts and trim rods?

________________________________
Chandan Sharma Subedi
Department of Mechanical Engineering
Massachusetts Institute of Technology
premphy@mit.edu | 617-608-8694

________________________________
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

Thread 53 (2015-11-30):

Mounting holes are too small

eric-wieser, 2015-11-30:
Same as #24, different holes

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

eric-wieser, 2015-12-01:
Now M2.5 clearance

eric-wieser, 2015-12-01:
But wait, there's more!

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

Closed 2015-12-01.

Thread 54 (2015-12-01):

More mounting holes are too small

eric-wieser, 2015-12-01:
But wait, there's more! (following on from #53)

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

premphy, 2015-12-01:
Done

Closed 2015-12-01.

Thread 55 (2015-12-01):

Motor driver is missing its magic smoke

eric-wieser, 2015-12-01:
:(

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

eric-wieser, 2015-12-01:
There's a new arduino and motor driver in the box. It'd be good to verify the motors are ok with a power supply before we blow the last driver

eric-wieser, 2015-12-01:
Put a new one in. Everything seems ok.

Closed 2015-12-01.

Thread 60 (2015-12-03):

Implement arm torque control

eric-wieser, 2015-12-03:
Things to note:
* Overloads happen
* They can be detected with `motor.get_errors().Overload`
* They can be reset by setting `TorqueLimit` back to non-zero
* Doing this can cause overheats if done too often!

premphy, 2015-12-03:
Can someone open the door? Thanks
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

eric-wieser, 2015-12-03:
By which I mean set `tau = tau_pid + tau_static`

reaganm, 2015-12-03:
Dynamixel Conn got super fucked up and I don't know how to fix it. If you
have a copy of the correct code somewhere on your laptop, can you put it on
git under a new name?
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

eric-wieser, 2015-12-03:
`git checkout c77404105668dc7884b93296049e6c13349ce21f -- 'software/Dynamixel*.m'` will fix your problem

reaganm, 2015-12-03:
I did this but can't get anything

On Thu, Dec 3, 2015 at 3:21 PM, Eric Wieser <notifications@github.com>
wrote:

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

reaganm, 2015-12-03:
The dynamixel wizard won't allow me to reset the torque limit. how do i do
this?

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
