eric-wieser/2.12-robot/software/embedded/RobotPosition.cpp

#include "RobotPosition.h"

#include <math.h>
#include "constants.h"

//RobotPosition Class function implementation
RobotPosition::RobotPosition() : pos(0, 0) {
  Phi = 0;
  pathDistance = 0;
}

void RobotPosition::update(float dThetaL, float dThetaR) {
  float dPhi = (r / (2.0 * b)) * (dThetaR - dThetaL);
  Angle AvgPhi = Phi + dPhi / 2;
  float dX = (r / 2.0) * cos(AvgPhi) * (dThetaR + dThetaL);
  float dY = (r / 2.0) * sin(AvgPhi) * (dThetaR + dThetaL);

  pos.x += dX;
  pos.y += dY;
  Phi += dPhi;
  pathDistance += sqrt(dX * dX + dY * dY);
}
