eric-wieser/2.12-robot/software/embedded/PathPlanner.cpp

#include "PathPlanner.h"

#include "Arduino.h"
#include "constants.h"
#include "RobotPosition.h"
#include "SerialCommunication.h"
#include "util.h"

//PathPlanner Class function implementation
PathPlanner::PathPlanner() {
  currentTask = Task::IDLE;
  desiredMVL = 0;
  desiredMVR = 0;
}

bool PathPlanner::OrientationController(const RobotPosition & robotPos, const SerialCommunication & reportData) {
  const float eps = .01;
  float KPhi = .50;

  Vector delta = reportData.commandPos - robotPos.pos;
  if(reportData.commandIsReversed) delta = -delta;

  Angle phiGoal = delta.angle();
  float phiError = phiGoal - robotPos.Phi;

  if (abs(phiError) > PI/3){
    KPhi = 10.0;
  }

  desiredMVR += KPhi * phiError*2.0*b;
  desiredMVL -= KPhi * phiError*2.0*b;

  return delta.magnitudeSq() < eps*eps;
}

void PathPlanner::turnToGo(const RobotPosition & robotPos, SerialCommunication & reportData) {
  //take next point (X,Y) positions given by MatLab, calculate phi to turn towards, then go straight

  if (currentTask == Task::IDLE) { // waiting to receive command x,y
    desiredMVR = 0;
    desiredMVL = 0;
    if (!reportData.finished){
      currentTask = Task::TURN;
      turnBegin = robotPos.Phi;

      if(reportData.commandIsTurn) {
        turnEnd = reportData.commandPhi;
      }
      else {
        Vector dist = reportData.commandPos - robotPos.pos;

        // skip small movements
        if(dist.magnitudeSq() < 0.025*0.025) currentTask = Task::DONE;

        turnEnd = (reportData.commandIsReversed ? -dist : dist).angle();
      }
    }
  }

  if (currentTask == Task::TURN) { //turn towards next point
    static const Spline turnSpline(0, 1, 0.3, 0.1);

    // interpolate our motor speeds quadratically in angle
    float through_turn = unlerp(turnBegin, turnEnd, robotPos.Phi);
    float speed = sgn(turnEnd  - turnBegin) * turnSpline.eval_dp(through_turn);

    desiredMVR = speed;
    desiredMVL = -speed;

    // move on
    if(through_turn >= 1 || turnBegin == turnEnd) {
      desiredMVR = 0;
      desiredMVL = 0;
      currentTask = Task::STRAIGHT;
      pathGoal = robotPos.pathDistance + (reportData.commandPos - robotPos.pos).magnitude();

      // if we're just turning, this is our last step
      if(reportData.commandIsTurn) currentTask = Task::DONE;
    }
  }

  if (currentTask == Task::STRAIGHT) { //now go straight to next point
    float speed = 0.4;

    // slow down near the goal
    const float slow_within = 0.2;
    const float slow_to = 0.15;
    float to_go = pathGoal - robotPos.pathDistance;
    if (to_go < slow_within)
      speed = lerp(slow_to, speed, to_go / slow_within);

    if (to_go > 0) {
      //if we aren't there yet, keep going
      desiredMVR = speed;
      desiredMVL = speed;
      if(reportData.commandIsReversed) {
        desiredMVR = -desiredMVR;
        desiredMVL = -desiredMVL;
      }
      bool done = OrientationController(robotPos, reportData);
      if(done) currentTask = Task::DONE;
    } else {
      currentTask = Task::DONE;
    }
  }
  if (currentTask == Task::DONE) { //done
    desiredMVR = 0;
    desiredMVL = 0;
    currentTask = Task::IDLE;
    Serial.println("NEXT POINT");
    reportData.updateStatus(true);
  }
}
