eric-wieser/2.12-robot/software/embedded/Angle.h

#pragma once

#include <math.h>

/**
A class representing an angle, and dealing with wraparound in [-PI, PI)

	Angle + float -> Angle
	Angle - float -> Angle

Example:

    float d_angle = Angle(1.5*M_PI) - Angle(0.25*M_PI);
    assert(d_angle == -0.75*M_PI)

*/
class Angle {
private:
	mutable float _value;
	static float normalize(float theta);
public:
	Angle() {}
	Angle(float f) : _value(f) {};

	// type preserving operators
	friend inline Angle operator +(Angle a, float da) { return a._value + da; }
	friend inline Angle operator +(float da, Angle a) { return a._value + da; }
	friend inline Angle operator -(Angle a, float da) { return a._value - da; }

	// conversion operators
	friend inline float operator -(Angle a, Angle b) { return normalize(a._value - b._value); }
	inline operator float() const { return _value = normalize(_value); }

	// augmented assignment operators
	inline Angle& operator +=(float da) { _value += da; return *this; }
	inline Angle& operator -=(float da) { _value -= da; return *this; }

	// places where conversion to float isn't necessary
	friend inline float cos(Angle a) { return cosf(a._value); }
	friend inline float sin(Angle a) { return sinf(a._value); }
	friend inline float tan(Angle a) { return tanf(a._value); }
};


// when unlerping angles, we want the discontinuity far from the ends
inline float unlerp(Angle a, Angle b, Angle lerped) {
	float span = b - a;
	Angle center = a + span/2;
	return 0.5 + (lerped - center) / span;
}
