eric-wieser/2.12-robot/(commit log)

2015-10-30 Initial attempt at rail assembly
    [Rail.SLDASM]
2015-10-30 Added MX-*T Motors
2015-10-31 Add an axis to the idler assembly
2015-10-31 Add start of vertical rail assembly
    [IdlerPlate.sldprt, Rail.SLDASM, Trolley.sldasm]
2015-10-31 Add servo "horn" part, delete now-converted STP files for the servos
2015-10-31 Add outline of custom pulley
    [Servo Timing Pulley 30 Tooth.SLDPRT]
2015-10-31 Add axis to timing pulley, put into assembly alongside servo
    [Rail.SLDASM, Servo Timing Pulley 30 Tooth.SLDPRT]
2015-10-31 Use feature-detection on the 106 motors (using some stranger on the internet's non-crippled solidworks)
2015-10-31 Remove the horn from the MX106 model
    [Rail.SLDASM]
2015-10-31 Add planes to the double rail
2015-11-01 1st rail to frame assembly
    Problem of height: 1mm space between bottom of motor and ground.
    Solution would be to cut part of T slotted frame to increase space
    [Assem1.SLDASM, Hand.SLDPRT, Hand2.SLDPRT, Rail.SLDASM, Robot_Base_2.SLDASM, Triangle_Bracket.SLDPRT]
2015-11-02 Move triangle bracket to third party (Issue #8)
    Assuming we want this folder to mean "hardware is third party", not "software is"
    [Robot_Base_2.SLDASM]
2015-11-02 Correct hole alignment of bracket, align planes with edges
    This breaks the assembly
2015-11-02 Correct the midplanes of the rail
    [Rail.SLDASM]
2015-11-02 Result of running rebuild to update inter-part constraints
    [IdlerPlate.sldprt]
2015-11-02 Correct mating constraints to use midplanes rather than fix
    [Robot_Base_2.SLDASM]
2015-11-02 Finish off idler plate(s)
    Closes #2
    [IdlerPlate.sldprt, Rail.SLDASM]
2015-11-02 Work on fixing #11
    [IdlerPlate.sldprt, Rail.SLDASM]
2015-11-02 Update robotbase to mate with new rail, and add a generated mirrored rail
    [MirrorRail.SLDASM, Robot_Base_2.SLDASM]
2015-11-02 Add base robot cad from stellar
    [6-32Screw.SLDPRT, 6-32x0_625 T-Nut BLOCK.SLDBLK.SLDPRT, 6-32x0_625 T-Nut.SLDPRT, 6-32x0_75 T-Nut.SLDPRT, 8020_corner.SLDPRT, 8020_extrusion.SLDPRT, Arduino UNO.SLDPRT, BaseStandoff.SLDPRT]
2015-11-02 Update robotbase to use provided cad model
    [Robot_Base_2.SLDASM]
2015-11-02 Suppress the parts that we're not using from the provided cad
    [TopAssembly.SLDASM]
2015-11-02 Added sifter
    Some fastener holes still need to be added
    [Back_plate.SLDPRT, Bottom_plate.SLDPRT, Bottom_side_panel.SLDPRT, Chicken_wire.SLDPRT, Sifter.SLDASM, Top_side_panel.SLDPRT, front_plate.SLDPRT]
2015-11-02 Fix rail mates, add sifter
    Can't drag the trolleys, for some reason...
    [Robot_Base_2.SLDASM]
2015-11-02 Move top-level assembly to top level
    Delete manual versioning of assemblies - we have git for that!
    [Robot_Base.SLDASM, Robot_Base_2.SLDASM, Top.SLDASM]
2015-11-02 Move rail stuff to a subdirectory
    [IdlerPlate.sldprt, MirrorRail.SLDASM, Rail.SLDASM, Servo Timing Pulley 30 Tooth.SLDPRT, Top.SLDASM, Trolley.sldasm]
2015-11-02 made motor mount
    seems like servo holes are for M2.5 and other holes are M5
    [Motor Mount.SLDPRT]
2015-11-03 Servo fixed to rail - missing fixation pulley with bearings
    [MirrorRail.SLDASM, Motor Mount.SLDPRT, Rail.SLDASM, Top.SLDASM, TopAssembly.SLDASM, kinect shelf side panel.SLDPRT]
2015-11-03 Add motor mount to assembly
    [MirrorRail.SLDASM, Rail.SLDASM]
2015-11-03 Updated hand assembly. Need dimension of pulleys and servos. (cant open the files from here)
    [Hand_assembly.SLDASM]
2015-11-03 Updated files with parts and VS 2A servo.
    If we are to use three degree of freedom hand, then we will be needing
    an additional servo. I have used servo VS 2A here for link 3.
    [Assem1.SLDASM, CROSS OUT FT FOR VS-2.sldprt, Futaba 3pin connector_26mm.sldprt, Hand.SLDPRT, Hand2.SLDPRT, HandLink1.SLDPRT, HandLink2.SLDPRT, HandLink3.SLDPRT]
2015-11-04 Assembly with rail for arm. Question: how many supporting L brackets necessary for fixing the rail ?
    [47065T147 End feed fastener screws.SLDPRT, 47065T147 End feed fastener without screws.SLDPRT, 47065T147 End feed fastener.SLDPRT, 5537T441.SLDPRT, Top.SLDASM]
2015-11-04 Rotate motor mount 90 degrees.
    This makes the upper section of the rail usable by the rollers.
    This also raises the issue that the 1/4in plate is a depth such that all available M5 screws are too long or too short
    [Motor Mount.SLDPRT, Rail.SLDASM]
2015-11-04 Fix bad mates in top assembly, and remove duplicated bolts
    [Top.SLDASM]
2015-11-04 Update mirrored rail
    [MirrorRail.SLDASM, Rail.SLDASM, Top.SLDASM]
2015-11-04 No deliberate changes
    Commit all the files that solidworks decided to modify from a clean checkout (rebuild/upgrade/corrupt/who knows), to make it shut up
    [MirrorRail.SLDASM, Rail.SLDASM, Top.SLDASM, TopAssembly.SLDASM, Trolley.sldasm, kinect shelf side panel.SLDPRT]
2015-11-04 Slight updates to pulley wheel
    [Rail.SLDASM, Servo Timing Pulley 30 Tooth.SLDPRT]
2015-11-04 Fixed problem with motor mount
    [MirrorRail.SLDASM, Rail.SLDASM, Top.SLDASM]
2015-11-05 Add a drawn-from-scratch timing pulley
    [Pulley 30 tooth.SLDPRT]
2015-11-05 Rotate so axis is normal to right plane
    [Pulley 30 tooth.SLDPRT]
2015-11-05 Derive the servo pulley part from the generic pulley part
    [Servo Timing Pulley 30 Tooth.SLDPRT]
2015-11-05 Update the rail assembly with the new servo pulley
    This works on #1
    [Rail.SLDASM]
2015-11-05 Add some holes for mounting. No room for bolts...
    Maybe M2.5 grub screws, if they're a thing?
    [Servo Timing Pulley 30 Tooth.SLDPRT]
2015-11-05 Updated linking bar between rails. Assemble arm on this bar.
    [Rail.SLDASM, Top.SLDASM]
2015-11-06 Add the hole needed to clear the servo horn, and the first of the four screwholes
    Unfortunately, solidworks silently fails to create a circular pattern of these holes...
    [Servo Timing Pulley 30 Tooth.SLDPRT]
2015-11-06 Rebuild assembly with new pulley.
    Servo mount is not able to connect properly yet
    [Motor Mount.SLDPRT, Rail.SLDASM, Servo Timing Pulley 30 Tooth.SLDPRT]
2015-11-06 Redesign motor mount to be offset by spacers
    [Motor Mount.SLDPRT, Rail.SLDASM, Servo Timing Pulley 30 Tooth.SLDPRT]
2015-11-06 Hide construction geometry
    [Motor Mount.SLDPRT, Rail.SLDASM, Servo Timing Pulley 30 Tooth.SLDPRT]
2015-11-06 Add the three remaining screwholes to fasten to the servo pulley (#1)
    Todo: add a bearing?
    [Servo Timing Pulley 30 Tooth.SLDPRT]
2015-11-06 Add bearings to the pulley, and use a bolt as the shaft.
    Assuming this thing is actually printable, this closes #1
    [Rail.SLDASM, Servo Timing Pulley 30 Tooth.SLDPRT, Servo pulley with shaft.SLDASM]
2015-11-06 Assembled the arm to the connecting rail
    [FR07-S101.SLDPRT, HN05-N102.SLDPRT, HandLink1Mount.SLDPRT, MX-106T with Horn.SLDASM, MX-106T.SLDPRT, MX-64T.SLDPRT, ServoMountArm.SLDPRT]
2015-11-06 Added the servomounts
    [Hand_assembly.SLDASM, MID_PLANT.sldprt, Output gear(M0.4x42T_FT).sldprt, SCREW M2.0XL28(None).sldprt, VS-2 ASS'Y.SLDASM, chassis lower(None).sldprt, chassis upper(None).sldprt]
2015-11-06 Duplicate link holder, use outer screwholes, fix mates
    [MirrorRail.SLDASM, Top.SLDASM]
2015-11-06 Group components into folders
    [Top.SLDASM]
2015-11-06 Group more components
    [MirrorRail.SLDASM, Rail.SLDASM]
2015-11-06 Lower crossbar
    [Top.SLDASM]
2015-11-07 Replace copied part with derived part
    [Link.SLDPRT, Top.SLDASM]
2015-11-11 Arm update, no pulley; three link with three servos on them, added to assembly, bushings to go on the joints (I have them with me)
    [HandLink1Mount.SLDPRT, Hand_assembly.SLDASM, MirrorRail.SLDASM, Rail.SLDASM, Servo Timing Pulley 30 Tooth.SLDPRT, Servo pulley with shaft.SLDASM, ServoHornLink2.SLDPRT, ServoMountArm.SLDPRT]
2015-11-11 Changed the references so that files can be opened now..sorry about that
    [HandLink1.SLDPRT, HandLink1Mount.SLDPRT, HandLink2.SLDPRT, HandLink3.SLDPRT, Hand_assembly.SLDASM, ServoHornLink2.SLDPRT, ServoMountArm.SLDPRT]
2015-11-11 Move VS-2 model into third-party
    [Hand_assembly.SLDASM, VS-2 ASS'Y.SLDASM]
2015-11-11 Add mates to center end-point along right plane
    [Hand_assembly.SLDASM]
2015-11-11 Mate arm with assembly, again, thereby completing the merge
2015-11-11 Do all the rebuilds requested by solidworks. This commit can be overwritten freely
    [Link.SLDPRT, MirrorRail.SLDASM, Rail.SLDASM, Servo Timing Pulley 30 Tooth.SLDPRT, Servo pulley with shaft.SLDASM, TopAssembly.SLDASM, kinect shelf side panel.SLDPRT]
2015-11-12 Make motor assembly flexible, and correct mates to allow this to work
    [Hand_assembly.SLDASM]
2015-11-12 Solidworks rebuild
    [Link.SLDPRT, MirrorRail.SLDASM, Rail.SLDASM, Servo Timing Pulley 30 Tooth.SLDPRT, Servo pulley with shaft.SLDASM]
2015-11-12 Updated the length of links, link 1 and link 2 are both 60 cm now.
    # Conflicts:
    # Parts/Hand/Hand_assembly.SLDASM
    # Parts/Rail/MirrorRail.SLDASM
    # Parts/Rail/Rail.SLDASM
    # Parts/Rail/Servo Timing Pulley 30 Tooth.SLDPRT
    # Parts/Rail/Servo pulley with shaft.SLDASM
    # Third-party/VS-2 Servo/VS-2 ASS'Y.SLDASM
    # Top.SLDASM
    [HandLink1.SLDPRT, HandLink2.SLDPRT, HandLink3.SLDPRT]
2015-11-13 Add first sheet of lasercutting
    [Sheet1.DXF, Sheet1.SLDASM, Sheet1.SLDDRW]
2015-11-13 Updated the hole and motor mount
    [HandLink1Mount.SLDPRT, HandLink2.SLDPRT, Hand_assembly.SLDASM, ServoMountArm.SLDPRT]
2015-11-13 Changed the length of Link3 to 12in
    [HandLink1.SLDPRT, HandLink3.SLDPRT, Hand_assembly.SLDASM]
2015-11-13 Add the second sheet
    [Sheet2.SLDASM]
2015-11-13 Add the second sheet, for #26
    [HandLink1.SLDPRT, HandLink2.SLDPRT, HandLink3.SLDPRT, Sheet2.SLDASM]
2015-11-13 Remove stray dimension
    [Sheet2.SLDASM]
2015-11-13 Add drawing file for second sheet
    [Sheet2.SLDDRW]
2015-11-13 Fixed the length, forgot to account for the bends
    [HandLink3.SLDPRT, Hand_assembly.SLDASM]
2015-11-13 Updated sifter
    [Back_plate.DXF, Back_plate.SLDPRT, Bottom_plate.DXF, Bottom_plate.SLDPRT, Bottom_side_panel.DXF, Bottom_side_panel.SLDPRT, Bottom_side_panel_1.DXF, Hooks.DXF]
2015-11-18 Rewrite encoder code to remove duplication
2015-11-19 Replace strings with enums.
    [embedded.ino]
2015-11-19 Remove code duplication for left vs right motor controller
2015-11-19 Use unsigned types for encoders, to allow safe overflow
2015-11-19 Remove numbering of wheels - just use L and R as soon as you read things
2015-11-19 replace PathPlanner code with the version that Matthieu and I used in the lab
    [PathPlanner.cpp, PathPlanner.h]
2015-11-19 Add an information dump
    [Dynamixel config.txt]
2015-11-20 Fix reboot loop due to recursion and stack overflow
    [Angle.h]
2015-11-20 changed sifter
    [Back_plate.SLDPRT, Bottom_plate.SLDPRT, Bottom_side_panel.SLDPRT, Sifter.SLDASM, front_plate.SLDPRT]
2015-11-20 Replace init with constructor
    [RobotPosition.cpp, RobotPosition.h, main.cpp]
2015-11-20 Add a test of motor and encoder wiring
2015-11-21 Move hardware to subfolder (fixes #39)
    [47065T147 End feed fastener screws.SLDPRT, 47065T147 End feed fastener without screws.SLDPRT, 47065T147 End feed fastener.SLDPRT, 47065T209.SLDPRT, 47065T209bis.SLDPRT, 47065T209ter.SLDPRT, 47065T236.SLDPRT, 47065T255.SLDPRT]
2015-11-21 Add a test for the encoders
2015-11-21 Fix typos in test
    [tests.cpp]
2015-11-21 Correct sign of left encoder
    [Drive.h]
2015-11-21 Fix motor control test
    [tests.cpp]
2015-11-22 New arm design without bends for waterjet. Dxf files also updated. VS-11 servo replaced instead of VS-2A for high torque.
    [HandLink1Mount.SLDPRT, HandLink1_new.SLDPRT, HandLink2_2_new.SLDPRT, HandLink2_new.SLDPRT, HandLink2_new_vs_11.SLDPRT, HandLink3.SLDPRT, HandLink3_2_new.SLDPRT, HandLink3_new.SLDPRT]
2015-11-22 Updated the assembly
    [TopAssembly.SLDASM, kinect shelf side panel.SLDPRT]
2015-11-22 Replace init() with constructors
    [PathPlanner.cpp, PathPlanner.h, SerialCommunication.cpp, SerialCommunication.h, main.cpp, main.h]
2015-11-23 Revert "replace PathPlanner code with the version that Matthieu and I used in the lab"
    This reverts commit 0d6ccc4cb598bafea5ac3fc3a1e532277bfba351.
    It seems that the code I had isn't very functional. The TAs code probably also needs work though
    [PathPlanner.cpp, PathPlanner.h]
2015-11-23 Replace multiple variables with a struct
    [PathPlanner.cpp, PathPlanner.h]
2015-11-24 Move arduino code into a class
2015-11-24 Add more packet types for arduino to PC
2015-11-24 Implement a servo and kill packet. AFAIAC, this closes #47
2015-11-24 Fix initial task number
    [PathPlanner.cpp]
2015-11-24 Quadratically interpolate the wheel speeds during a turn
2015-11-24 Don't even try to make movements smaller than 2.5 cm
2015-11-25 General cleanup
    * replace int with enum
    * make members private where not used externally
    * improve comments
    * delete unused LabTestRun function
    [PathPlanner.cpp, PathPlanner.h]
2015-11-29 Dynamixel code updated. Problem with speed (very slow to move up) and belt jumps often
2015-11-29 lasercutter files
2015-12-01 Remove unfold. I'm not even sure we use this file any more?
    [HandLink3.SLDPRT]
2015-12-01 Add bearing to parts library, in case we use it (#33)
2015-12-01 Fixes #53
    [HandLink1_new.SLDPRT, Hand_assembly_new.SLDASM, Sheet2.SLDASM]
2015-12-01 lasercutting parts
    made new folder, slightly modified cad
    [Back_plate.DXF, Back_plate_1.DXF, Bottom_plate.DXF, Bottom_plate.SLDPRT, Bottom_plate_1.DXF, Bottom_side_panel.DXF, Bottom_side_panel_1.DXF, Bottom_side_panel_2.DXF]
2015-12-01 Waterjet file for arm mount and servo mounts..
    [Sheet3_mounts.SLDASM, Sheet3_mounts.SLDDRW]
2015-12-01 Updated mounts..
    [HandLink1Mount.SLDPRT, HandLink1_new.SLDPRT, HandLink2_2_new.SLDPRT, HandLink2_new_vs_11.SLDPRT, Hand_assembly_new.SLDASM, ServoMountArm.SLDPRT, Sheet2.SLDASM, Sheet2.SLDDRW]
2015-12-01 Added scrapper
    [Scrapper.SLDPRT, Sheet4_scrapper.SLDASM, Sheet4_scrapper.SLDDRW]
2015-12-01 Updated assembly with scrapper
    [HandLink1Mount.SLDPRT, HandLink3_2_new.SLDPRT, HandLink3_new.SLDPRT, Hand_assembly_new.SLDASM, Servo Timing Pulley 30 Tooth.SLDPRT, Servo pulley with shaft.SLDASM, ServoMountArm.SLDPRT, Sheet2.SLDASM]
2015-12-01 Updated scrapper length
    [HandLink1Mount.SLDPRT, Hand_assembly_new.SLDASM, Scrapper.SLDPRT, ServoMountArm.SLDPRT, Sheet2.SLDASM, Sheet2.SLDDRW]
2015-12-01 Add a rail class
2015-12-01 Make the encoder counts public, for debugging
2015-12-01 Fix bug in feedback controller, seemingly due to overflow
    [MotorController.cpp]
2015-12-01 Update from GPS information.
    This makes the assumption that the data is both:
    * Realtime (zero latency)
    * Correct
    Which is probably not safe to assume
    [main.cpp]
2015-12-01 Replace rail test with uses of the class
2015-12-02 Add skeleton code for arm and main program
2015-12-02 Fix sifter mates
    [Top.SLDASM]
2015-12-02 Put the arm in the right places, so it doesn't block the sifter.
    @premphy, did you not spot this?
    [Hand_assembly_new.SLDASM, Link.SLDPRT, Scrapper.SLDPRT, ServoMountArm.SLDPRT, Top.SLDASM]
2015-12-02 Added test arm path to follow
    To find actual arm path for sweeping we'll need arm
2015-12-02 Fix sheet view to show parts as flattened
    [HandLink1Mount.SLDPRT, ServoMountArm.SLDPRT, Sheet3_mounts.SLDASM, Sheet3_mounts.SLDDRW]
2015-12-02 reference for VS-11 servo control
2015-12-02 Lengthened motor mount
    [IdlerPlate.DXF, IdlerPlate.sldprt, Motor Mount.DXF, Motor Mount.SLDPRT, Rail.SLDASM, Servo Timing Pulley 30 Tooth.SLDPRT, Servo pulley with shaft.SLDASM, Trolley.sldasm]
2015-12-03 Servo library for VS-11
2015-12-03 New event-driven arduino interface
2015-12-03 Revert "Servo library for VS-11"
    This library is the same as the builtin arduino library - why would we want a copy?
    This reverts commit 112e605b5a41949a9eb1759ff5e526bb58e36cec.
2015-12-03 Revert "Position Control VS-11"
    This doesn't even compile.
    This reverts commit e4959bf7ceceb5b8068ed626213508ac4cbe3570.
    [VS11.cpp]
2015-12-03 Delegate VS11 code to servo, since it turned out it was actually that simple
2015-12-03 updated arm cad
    [HandLink1Mount.SLDPRT, Hand_assembly_new.SLDASM, Link.SLDPRT, Motor_mount_angled.DXF, Motor_mount_angled.SLDPRT, Servo Timing Pulley 30 Tooth.SLDPRT, Servo pulley with shaft.SLDASM, Top.SLDASM]
2015-12-03 Add message sequence ids, to prevent race conditions
    [SerialCommunication.cpp, SerialCommunication.h]
2015-12-03 Add code to forward on servo commands from matlab
2015-12-03 Turns out the motors have built-in support for the offsets we were using
2015-12-03 Log motor faults
2015-12-03 Fix motor driver fault reset
    [Drive.h]
2015-12-03 Disable the servo, because it overlaps with the motor pins
2015-12-03 changed arm mounting
    [Hand_assembly_new.SLDASM, Link.SLDPRT, Scraper_acrylic.DXF, Scraper_acrylic.SLDPRT, Servo Timing Pulley 30 Tooth.SLDPRT, Servo pulley with shaft.SLDASM, Servo-Scraper_link.DXF, Servo-Scraper_link.SLDPRT]
2015-12-03 Actually clean up the timer
2015-12-03 Changed scrapper dimensions
    [Scraper_acrylic.SLDPRT, Sheet4_scrapper.SLDASM]
2015-12-03 Add test verifying servo failure
    [tests.cpp]
2015-12-03 Expose error method on motor objects
